rytsh/tren/docs/standart.md

# Tren ortak standardı

Bütün lokomotif ve vagonların uyması gereken ölçü, bağlantı ve hat (bus) standardı. **Durum: tasarım önerisi.** Hiçbir parça basılmadı; çeki kolu, konnektör, akım ve veri hattı fiziksel olarak denenmedi. Varsayımlar `cad/params.json` içinde parametredir ve test sonrası değişebilir.

## 1. Ölçü

| | Değer | Not |
|---|---|---|
| Ray açıklığı | 45 mm | değişmez |
| Standart vagon şasisi | **250 × 90 mm** | eski 220 mm yolcu vagonunun yerine; 256 mm tablaya düz sığar |
| Gövde | ≤ 236 × 86 mm | çatı ayrı baskı |
| Boji merkezleri | ±75 mm (150 mm aralık) | boji aks aralığı 48 mm; uç tekerlek x = 122,5 mm, kiriş yüzü 125 mm |
| Kirişler arası | **40 mm** (iki 250 vagon); araç adımı 290 mm | R750'de iç tampon başları arası ≈ 11 mm (`coupling_calc.py`) |
| Gövde yüksekliği | ≤ 135 mm ray üstü (çatı dahil), donanım (radar vb.) ≤ 160 mm | lokomotif bacası 155 mm |
| Çeki kolu pim aralığı | lokomotif–tender 44 mm, tender–250 86 mm, 250–250 116 mm | `db_pitch`, `dbc_L_tender`, `dbc_L_car` |

R750'de 150 mm boji aralığı: gövde ortası yaklaşık 3,8 mm içe, uçlar yaklaşık 6,7 mm dışa kayar (s²/8R). Çeki kolu bunu pivotunda dönerek karşılar (≈ 11°, çentik ±12°); yan tamponlar yalnız görseldir ve virajda birbirine değmeyecek kadar geride durur.

## 2. Bağlantı: çeki kolu + ara kablo

Mekanik bağlantı ile elektrik ayrıdır. Önceki öneri (T45: koni–huni, mıknatıs, 8 pogo temas tek kafada) bu ölçekte fazla parça, ince duvar ve ±0,5 mm hizalama istediği için bırakıldı.

- **Çeki kolu.** Tek parça, düz basılan bir kol (8 × 5,5 mm). Her 250 vagonun **ön** ucunda, platform altındaki pivot göbeğine (kiriş yüzünden 38 mm içeride) alttan M3 vidayla takılır; öbür ucu öndeki aracın **arka** pivotuna gelir. Vida pulla takılır, sıkılmaz: kol iki pivotta da serbest döner. Kiriş altındaki çentik kola ±12° salınım verir.
- **Lokomotif ve tender.** Eski Faz 3 çeki çatalları kalır: lokomotif–tender arasında 44 mm kol; tender arka çatalı ile ilk 250 vagonun ön pivotu arasında 86 mm kol.
- **Kuvvet.** Çekme ve itmeyi yalnız kol ve pimler taşır. Tamponlar görseldir.
- **Elektrik.** Her araç gövdesinin iki alın duvarında bir **4 pinli kutuplu yuva** vardır (JST-XH 4P sınıfı, ölçü varsayım, ray üstünden ≈ 63 mm). Araçlar arasına 80 mm'lik, iki ucu fişli 4 damarlı **ara kablo** elle takılır. Kablo kuvvet taşımaz; yuvanın arkasında kablo bağıyla tutulur. Tender deposu da aynı 4 pinli yuvayı taşır; lokomotifte yuva yok, tenderden gelen kablo kabin arka açıklığından girer.

Pin sırası (yuvada kutuplama kanalı üstte, soldan sağa):

| Pin | Hat | Açıklama |
|---|---|---|
| 1 | **BAT+** | tren besleme hattı, 2S pil gerilimi 6,0–8,4 V, sigortalı |
| 2 | **CAN-H** | veri hattı |
| 3 | **CAN-L** | veri hattı |
| 4 | **GND** | ortak toprak |

## 3. TrenBus: güç + veri

- **Güç.** BAT+ hattı lokomotif ve **enerji vagonlarındaki** paketlerden beslenir. Her besleyici hatta ideal diyot ve akım sınırı (öneri 2 A) ile bağlanır; her tüketici araç girişinde PTC/eFuse (öneri 1 A) ve kendi düşürücü regülatörü (5 V / 3,3 V) vardır. Hiçbir modül BAT+ hattını doğrudan 5 V sanmaz.
- **Veri.** CAN 2.0, öneri 125 kbit/s. Her araçta küçük bir **araç düğümü**: mikrodenetleyici (ör. ESP32-C3) + 3,3 V CAN alıcı-verici (ör. SN65HVD230). Sonlandırma: lokomotifte sabit 120 Ω, son araçta arka yuva boşsa düğümün açtığı 120 Ω (öneri, doğrulanmadı).
- **Mesajlar (öneri).** Lokomotif periyodik `durum` (hız, yön, pil) yayınlar; araçlar `kalp atışı` ve kendi telemetrisini gönderir; lokomotif `komut` ile ışık, ses, radar gibi işlevleri açar. Araç sırası kalp atışlarından çıkarılır.
- **Şarj ayrı.** İstasyon şarj kontakları TrenBus'tan ayrı bir devredir; şarj akımı ara kablodan geçirilmez, şarj vagonu yalnız kendi paketini ve kendi döner kollarını kullanır (§5).

## 4. Araç ailesi (ilk set)

| id | Ad | Görev | Hat |
|---|---|---|---|
| `bd-040` | BD 0-4-0 lokomotif | çekiş, ana pil, CAN yöneticisi | BAT+ besler, CAN |
| `tender-160` | Tender 160 | kömürlük görünümünde ana pil | BAT+ besler |
| `yolcu-250` | Yolcu 250 | iç aydınlatma, pencere ışıkları | tüketir, CAN |
| `enerji-250` | Enerji vagonu | ek 2S paket + BMS, gerilim göstergesi | BAT+ besler, CAN |
| `radar-250` | Radar vagonu | dönen anten tablası, mesafe sensörü | tüketir, CAN |
| `sarj-250` | Şarj vagonu | döner şarj kolları, şarj durumu ışık çubuğu | kendi devresi, CAN |
| `ses-250` | Ses vagonu | hoparlör, düdük ve anons | tüketir, CAN |
| `gozlem-250` | Gözlem vagonu | kamera kubbesi, gözlem pencereleri | tüketir, CAN |

Hepsi ortak 250 mm şasi, iki boji, bir çeki kolu ve iki TrenBus yuvası kullanır; yalnız gövde ve üst donanım değişir. Gövde CAD parçaları (`cad/README.md` Faz 4c):

| id | Gövde parçaları | Üst yükseklik (ray üstü) |
|---|---|---|
| `yolcu-250` | `yolcu_govde`, `yolcu_cati` | ≈ 131 mm |
| `enerji-250` | `enerji_govde`, `enerji_cati` | ≈ 128 mm |
| `radar-250` | `radar_kabin`, `radar_cati`, `radar_kaide`, `radar_tabla`, `radar_direk`, `radar_anten` | çanak ≈ 147 mm |
| `sarj-250` | `sarj_platform`, `sarj_govde`, `sarj_cati`, `sarj_kol` | ≈ 100 mm |
| `ses-250` | `ses_govde`, `ses_cati` | ≈ 129 mm |
| `gozlem-250` | `gozlem_govde`, `gozlem_cati`, `gozlem_kubbe` | kubbe ≈ 134 mm |

## 5. İstasyon şarjı: döner kollar

**Durum: tasarım önerisi, CAD'i üretildi** (`cad/README.md` Faz 4, `sarj250_montaj`). Servo, yaprak yay ve lama ölçüleri varsayımdır; temas direnci ve akım denenmedi.

| | Değer | Parametre |
|---|---|---|
| Kol cebi | +y yan duvarında, 35 × 10 × 27 mm (boy × derinlik × yükseklik) | `sj_pk_*` |
| Mil ekseni | x = 12, y = 35 (araç merkezinden) | `sj_px`, `sj_py` |
| Kol boyu | milden tutucu ucuna 22 mm, yaprak yay +4 mm | `sj_arm_len`, `sj_shoe_out` |
| Yay stroku | 1,5 mm (istasyon lamasının bastırdığı) | `sj_travel` |
| Kutup | üst kol **+**, alt kol **−**; eksenler arası 18 mm | `sj_up_z`, `sj_lo_z` |
| İstasyon lama yüzü | ray ekseninden 59,5 mm | `sj_st_face` |
| Lama eksenleri | zeminden 72 mm (−) ve 90 mm (+) (ray üstünden ≈ 59 ve 77) | `sj_st_z_lo`, `sj_st_z_up` |
| Lama boyu | 90 mm temas yüzü (6 × 1 mm pirinç, 100 mm kesilir) | `sj_st_len` |

- **Vagon tarafı.** Tek parça döner kol: dikey göbek ve ona bağlı alt ve üst kol. Platform altındaki tek mikro servo (MG90S sınıfı) göbeği çeyrek tur döndürür, iki kol birlikte kapı gibi açılır. Kapalıyken kollar cebin içinde −x yönüne yatar ve gövde dış yüzünün içinde kalır.
- **Kol ucu.** Tutucudaki yuvaya fosfor bronz/pirinç yaprak yay şerit (5 × 0,3 mm) yapıştırılır ve dışarı kıvrılır. Lamaya servo kuvvetiyle değil yayla bastırır; servo açık konumda durur.
- **İstasyon tarafı.** `sarj_istasyon` tutucusu traverslerle aynı zemine oturur: iki direk ve üst üste iki taşıyıcı. Lamalar taşıyıcıların ray tarafındaki cebe girer, yüzleri plastiğin 0,5 mm önündedir; uçları direk yarığına bükülür. Lamalar 90 mm olduğu için vagonun ±40 mm kayık durması temasa engel olmaz.
- **Akış.** Mıknatıslar ve hall sensörüyle durulur, kollar açılır ve temas doğrulanana kadar lamalar enerjisiz kalır. Şarj biter, kollar cebe döner. Vagon ancak kollar kapandıktan sonra kalkar (servo konumu veya cepte bir uç anahtarı, öneri).
- **Koruma.** Vagon girişinde ters kutup koruması ve sigorta bulunur, BMS 2S paketi korur.

## 6. Görsel dil

Site ve Anatomy figürleri aynı sıcak, sarıya çalan paleti kullanır: kum sarısı zemin, krem çizim kâğıdı, sıcak koyu mürekkep, kırmızı tekerlek, işaret sarısı vurgu. Logo: [Lucide `train-track`](https://lucide.dev/icons/train-track).

| Token | Renk |
|---|---|
| ground | `#efe6c8` |
| plate (kâğıt) | `#faf5e4` |
| ink | `#2b2616` |
| mid | `#6e6448` |
| hair | `#d6caa3` |
| signal (vurgu sarısı) | `#e9b824` |
| red (tekerlek) | `#b3262a` |
