rytsh/tren/cad/renders/ceki_kolu.png

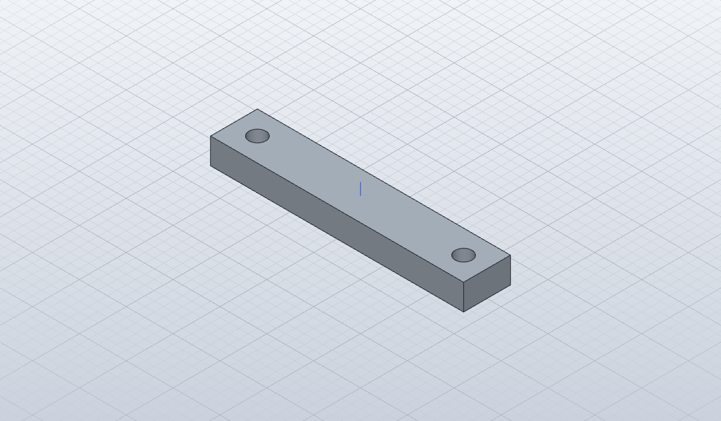
cad/renders/ceki_kolu.png
