rytsh/tren/cad/renders/ceki_kolu_250.png

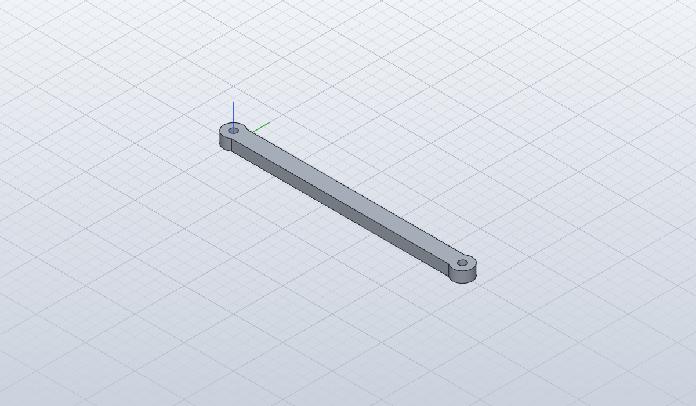
cad/renders/ceki_kolu_250.png
