rytsh/tren/cad/renders/ceki_kolu_tender_250.png

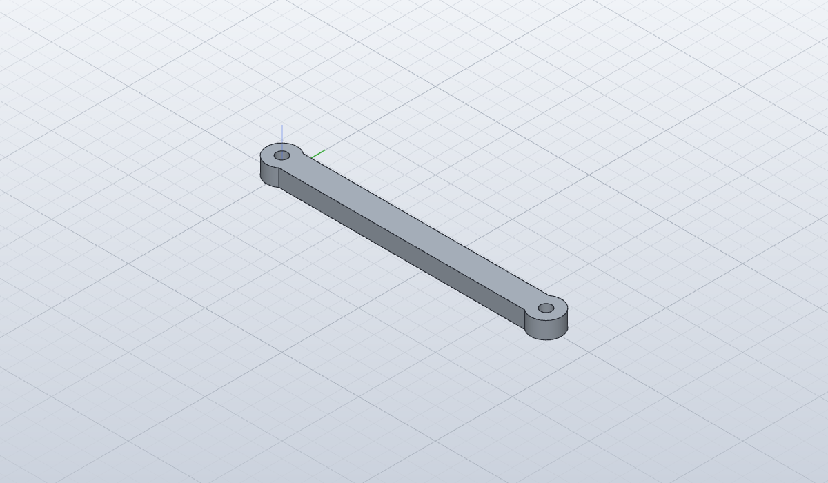
cad/renders/ceki_kolu_tender_250.png
