rytsh/tren/cad/renders/enerji_cati.png

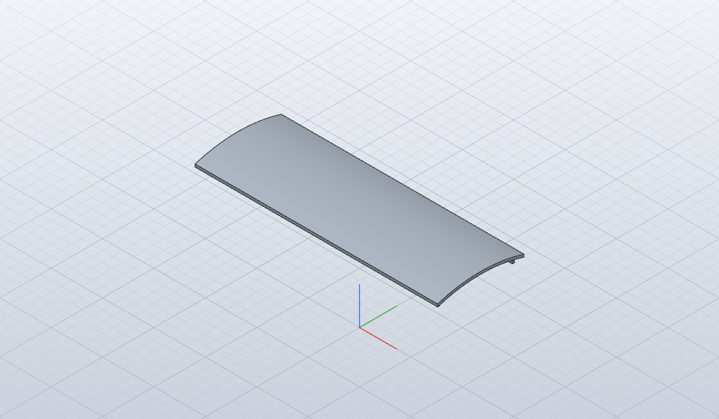
cad/renders/enerji_cati.png
