rytsh/tren/cad/renders/enerji_govde.png

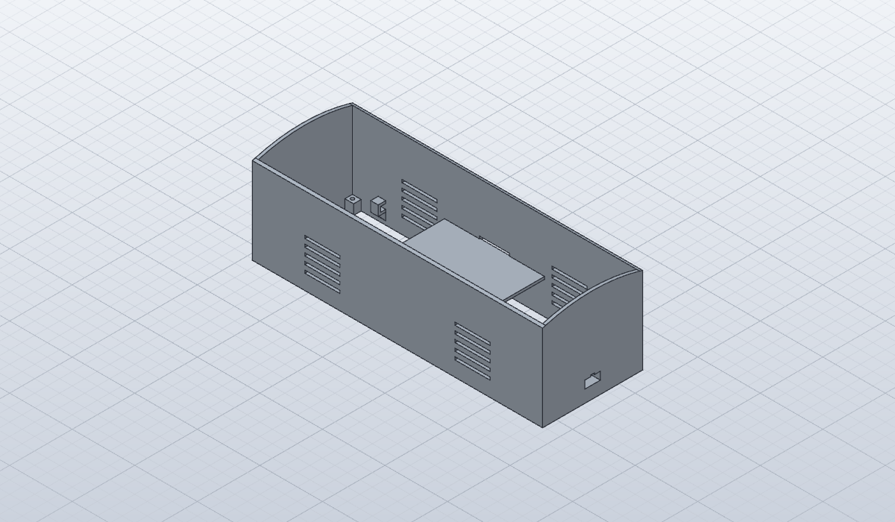
cad/renders/enerji_govde.png
