rytsh/tren/cad/renders/gozlem_cati.png

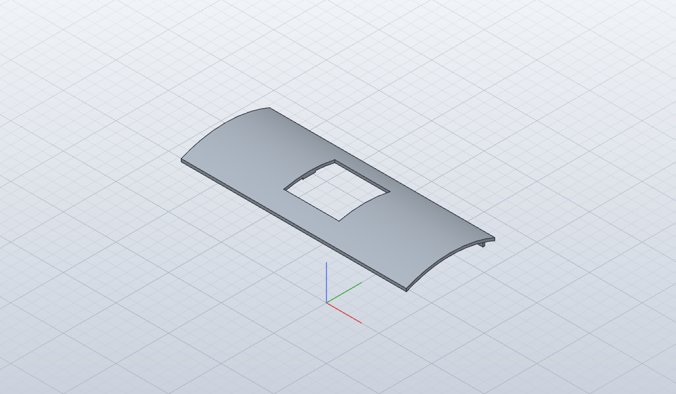
cad/renders/gozlem_cati.png
