rytsh/tren/cad/renders/gozlem_govde.png

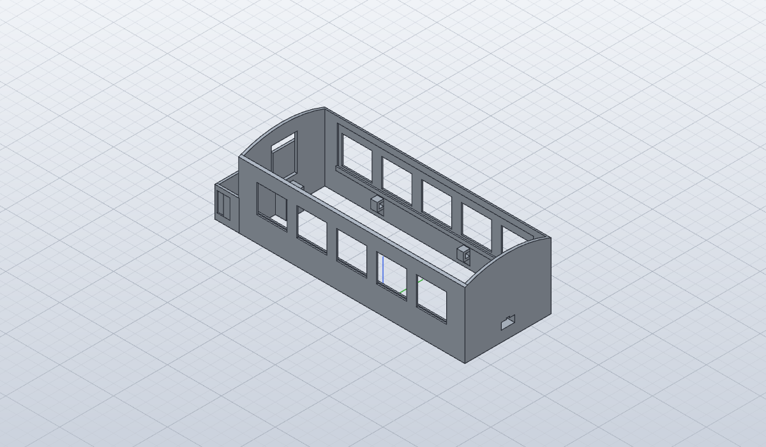
cad/renders/gozlem_govde.png
