rytsh/tren/cad/renders/gozlem_kubbe.png

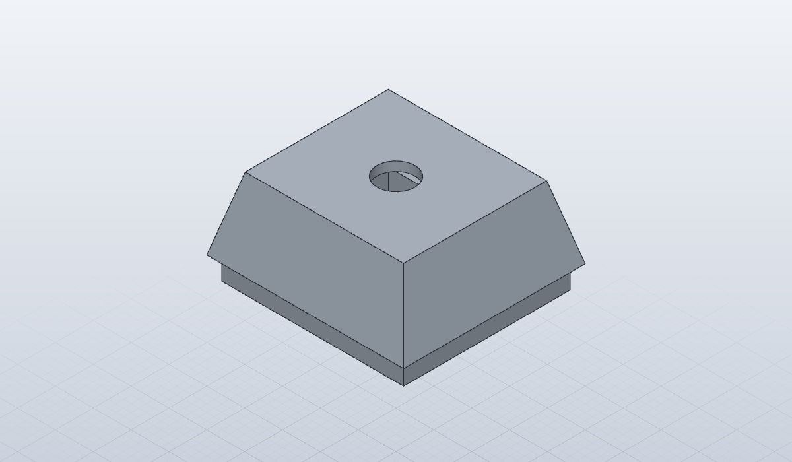
cad/renders/gozlem_kubbe.png
