rytsh/tren/cad/renders/karsi_disli_m1_z30.png

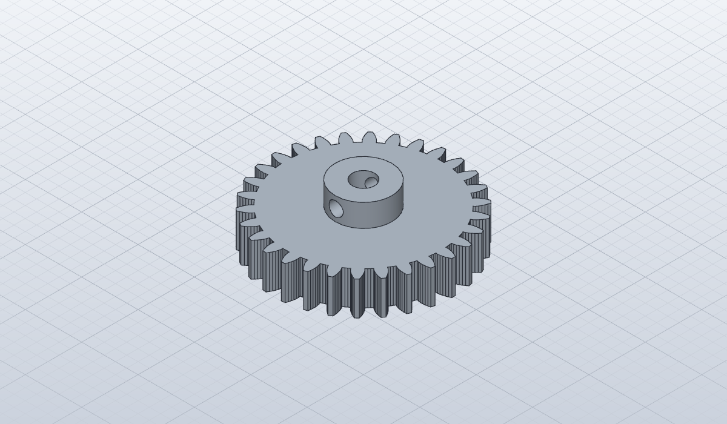
cad/renders/karsi_disli_m1_z30.png
