rytsh/tren/cad/renders/lok_baca.png

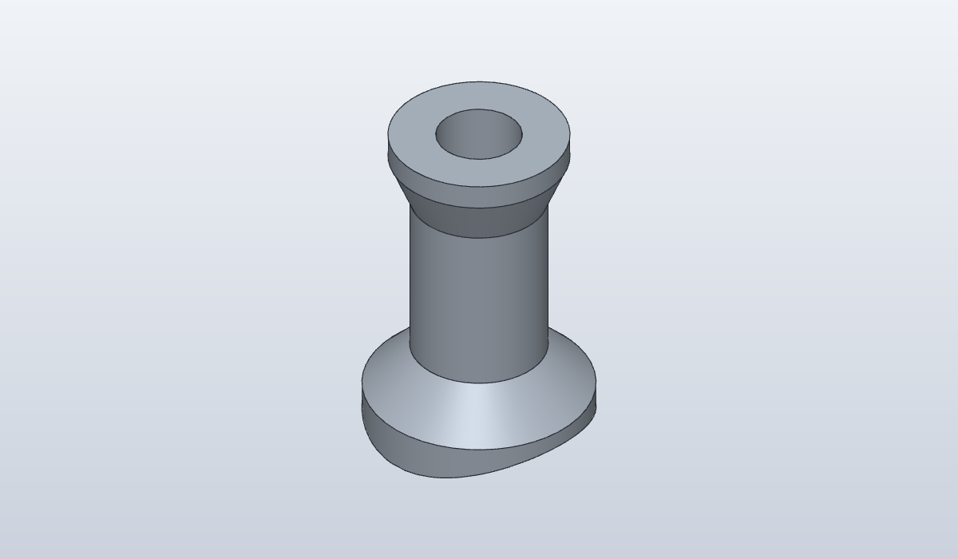
cad/renders/lok_baca.png
