rytsh/tren/cad/renders/lok_buhar_domu.png

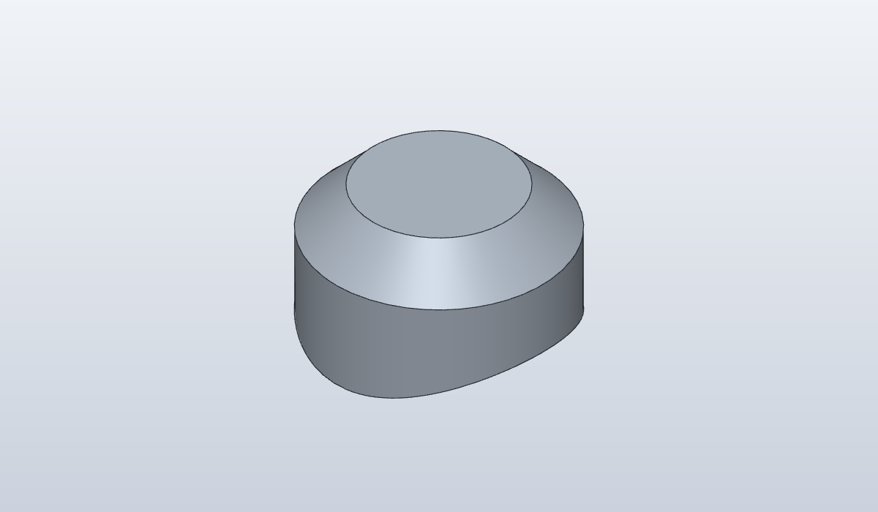
cad/renders/lok_buhar_domu.png
