rytsh/tren/cad/renders/lok_emniyet_ventili.png

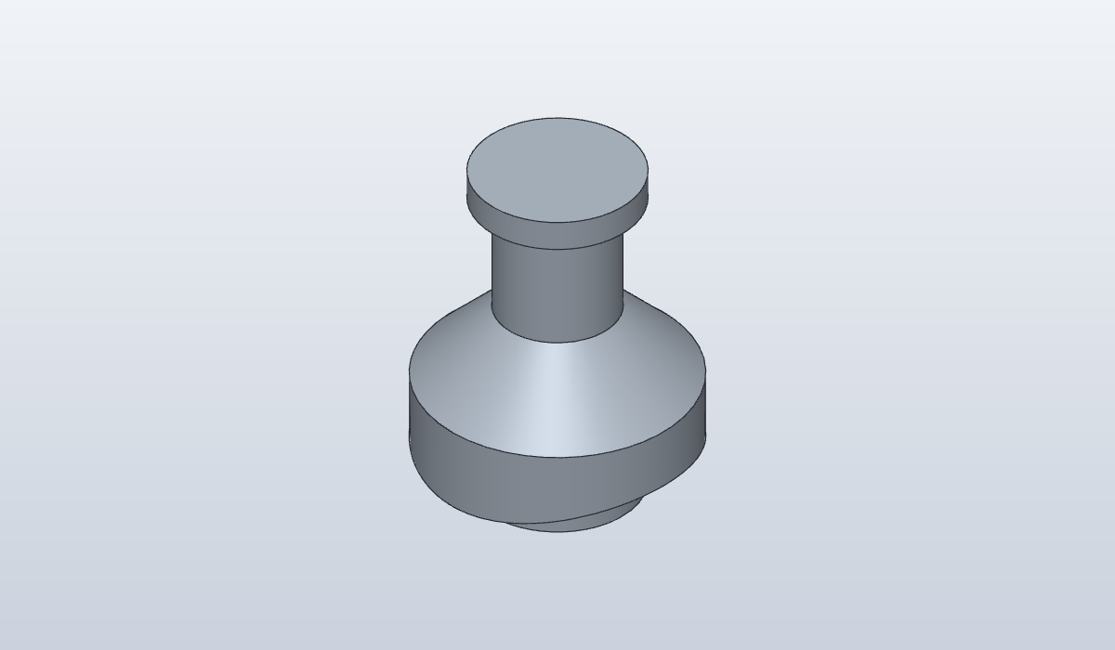
cad/renders/lok_emniyet_ventili.png
