rytsh/tren/cad/renders/lok_kabin.png

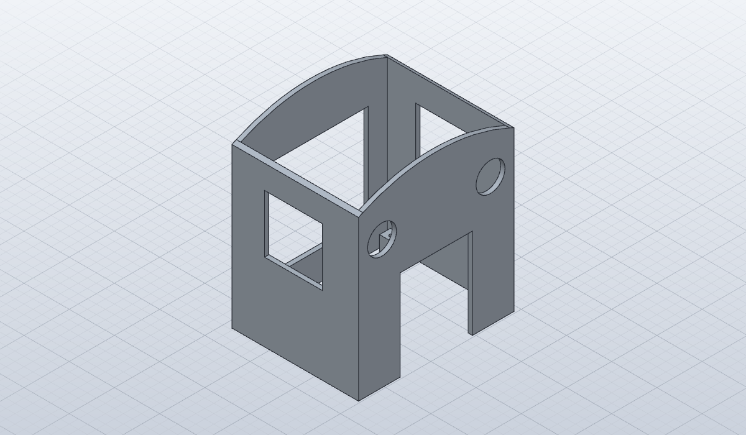
cad/renders/lok_kabin.png
