rytsh/tren/cad/renders/lok_kabin_cati.png

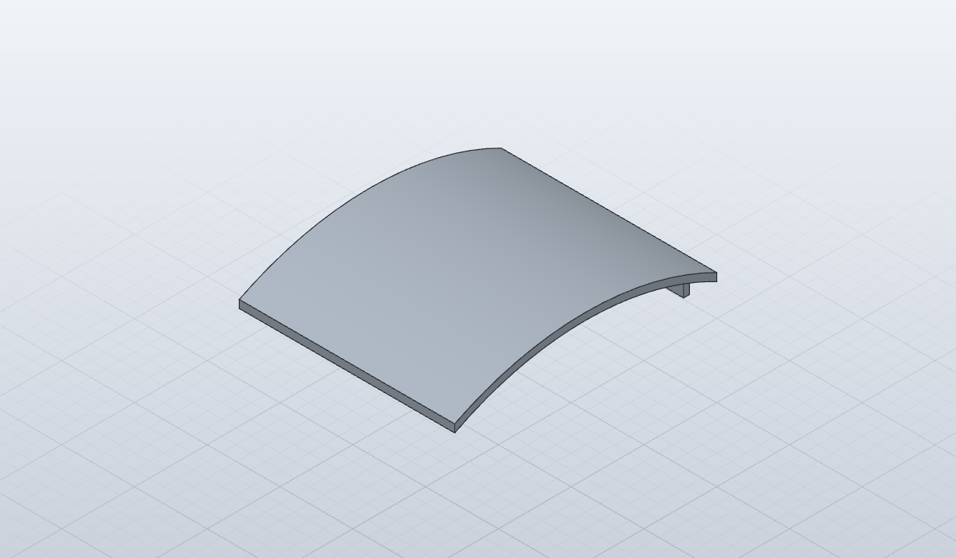
cad/renders/lok_kabin_cati.png
