rytsh/tren/cad/renders/lok_kazan.png

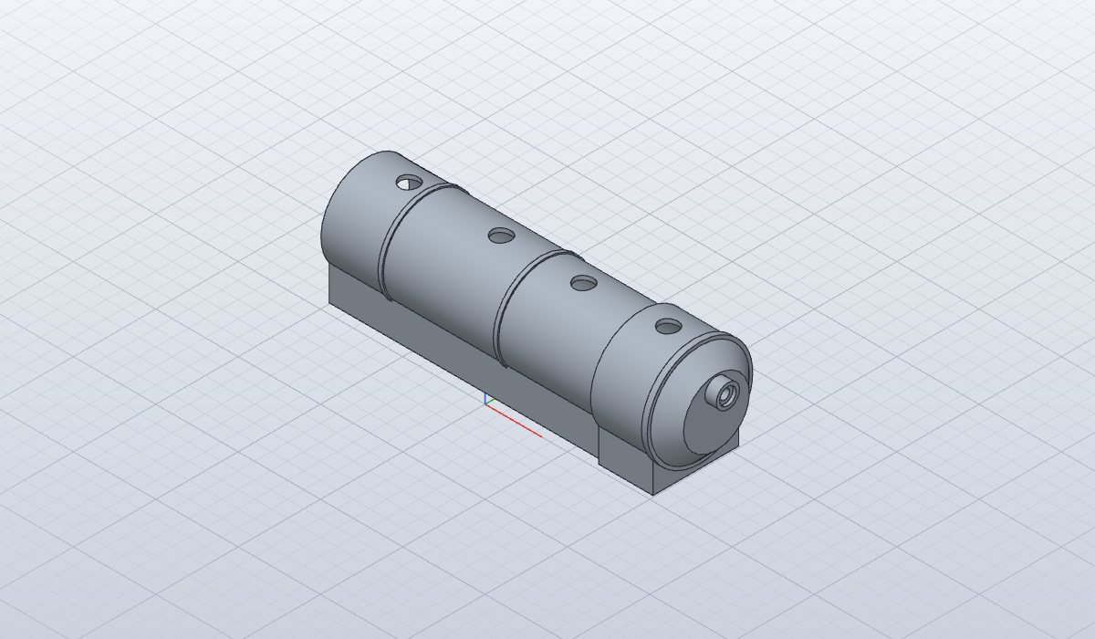
cad/renders/lok_kazan.png
