rytsh/tren/cad/renders/lok_platform_arka.png

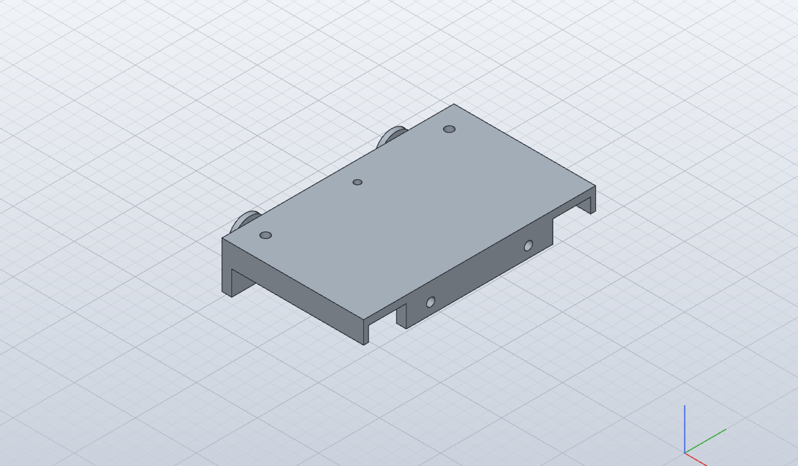
cad/renders/lok_platform_arka.png
