rytsh/tren/cad/renders/lokomotif_yan.png

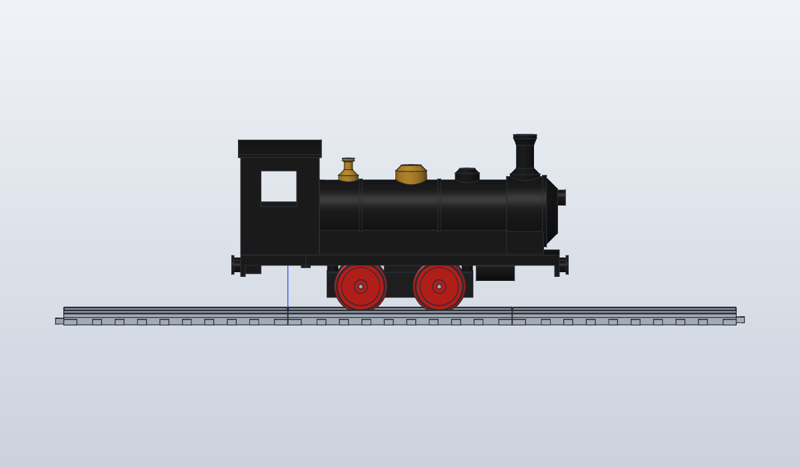
cad/renders/lokomotif_yan.png
