rytsh/tren/cad/renders/motorlu_iso.png

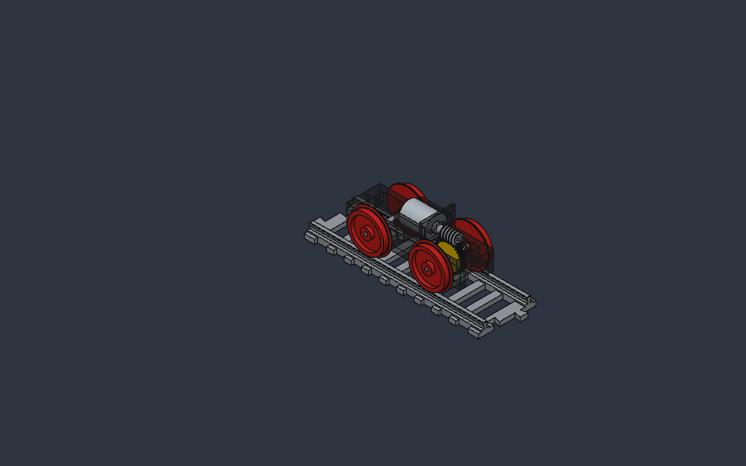
cad/renders/motorlu_iso.png
