rytsh/tren/cad/renders/motorlu_on.png

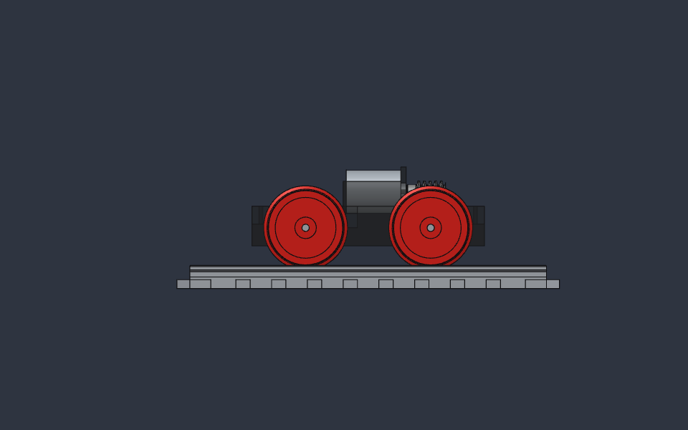
cad/renders/motorlu_on.png
