rytsh/tren/cad/renders/pul_aks_4mm.png

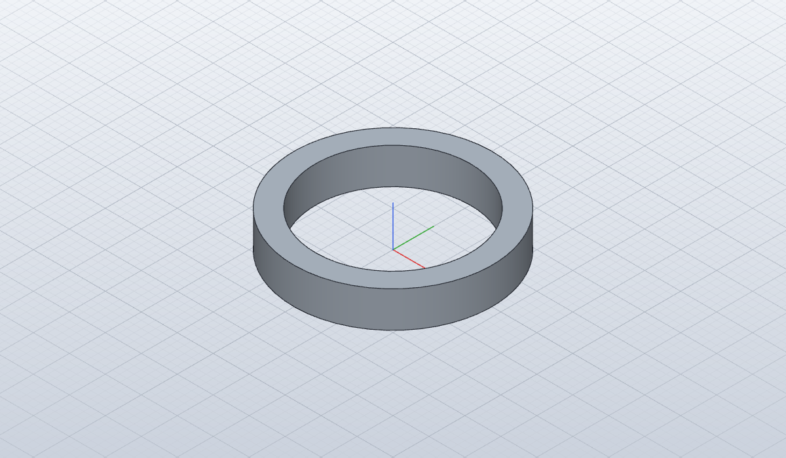
cad/renders/pul_aks_4mm.png
