rytsh/tren/cad/renders/radar_anten.png

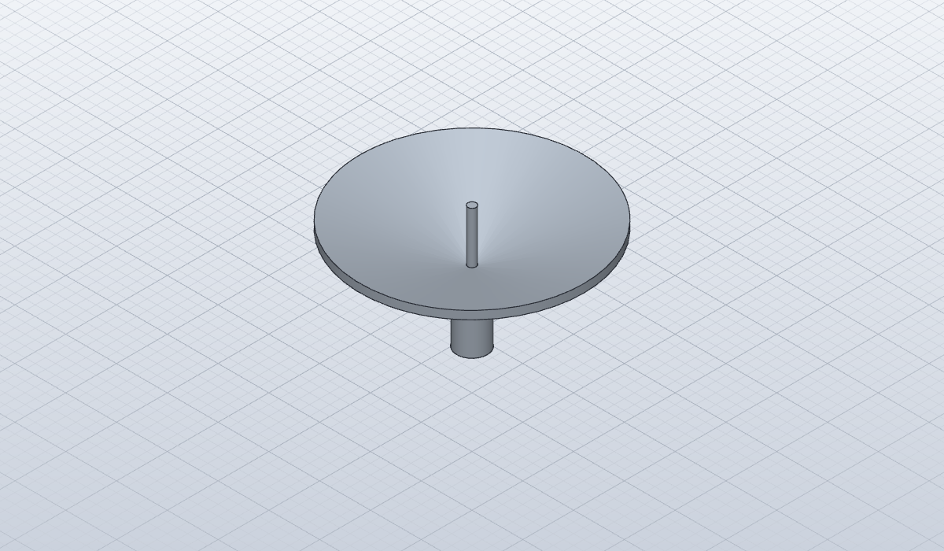
cad/renders/radar_anten.png
