rytsh/tren/cad/renders/radar_cati.png

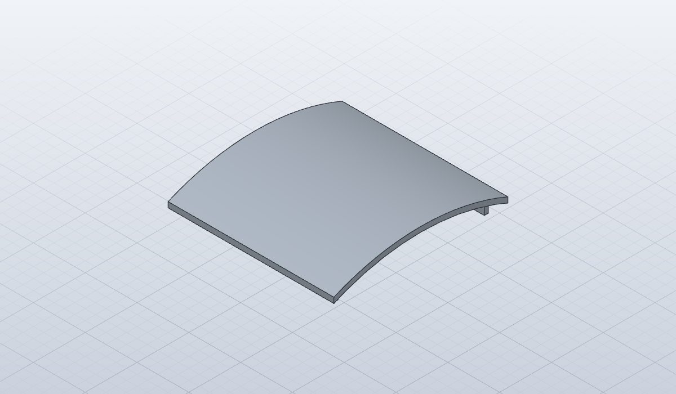
cad/renders/radar_cati.png
