rytsh/tren/cad/renders/radar_direk.png

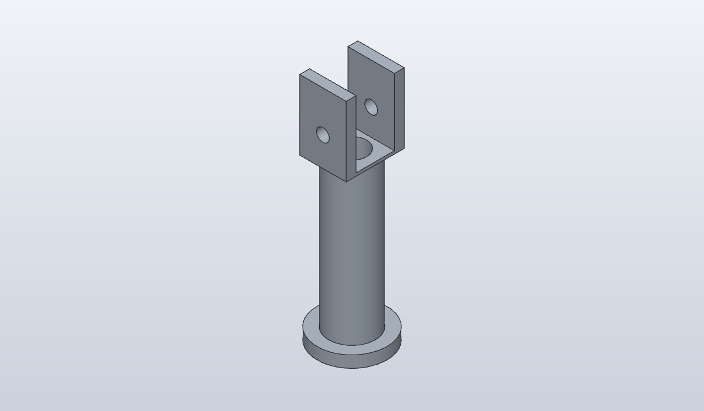
cad/renders/radar_direk.png
