rytsh/tren/cad/renders/radar_kabin.png

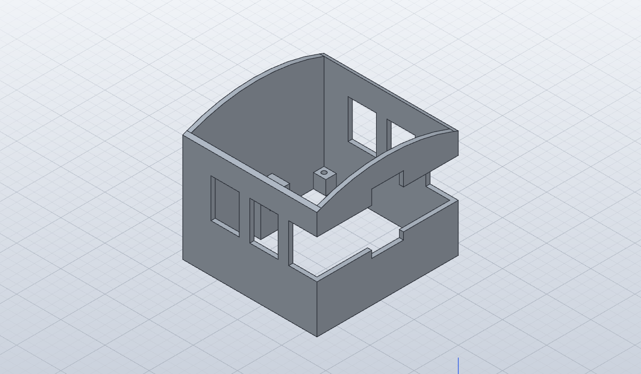
cad/renders/radar_kabin.png
