rytsh/tren/cad/renders/radar_kaide.png

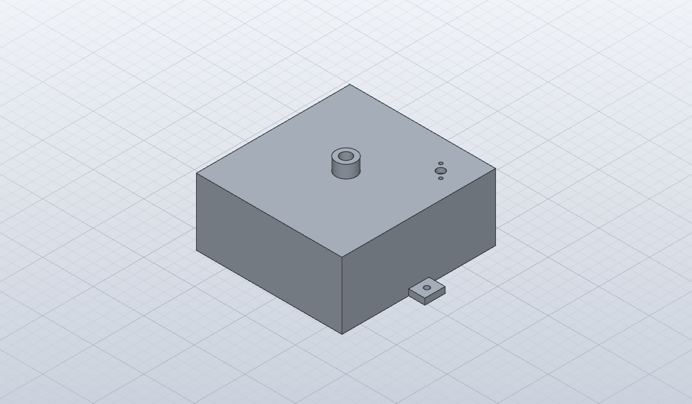
cad/renders/radar_kaide.png
