rytsh/tren/cad/renders/radar_tabla.png

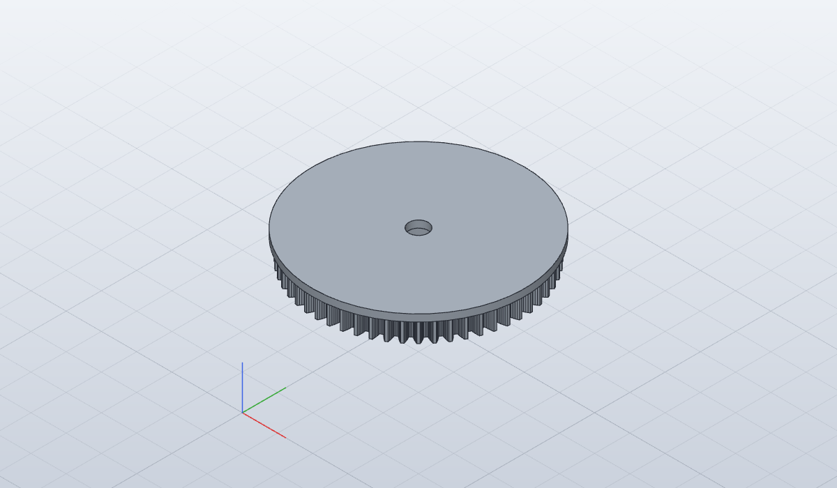
cad/renders/radar_tabla.png
