rytsh/tren/cad/renders/ray_duz_200.png

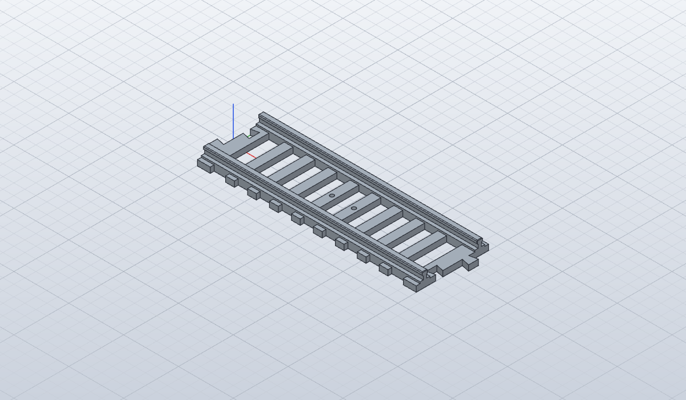
cad/renders/ray_duz_200.png
