rytsh/tren/cad/renders/ray_viraj_r750_15.png

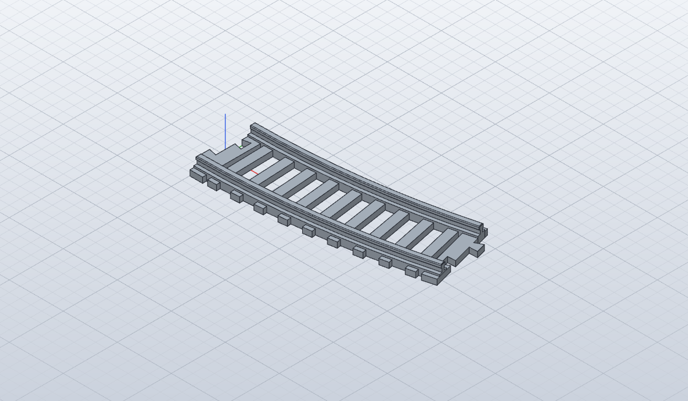
cad/renders/ray_viraj_r750_15.png
