rytsh/tren/cad/renders/sarj_cati.png

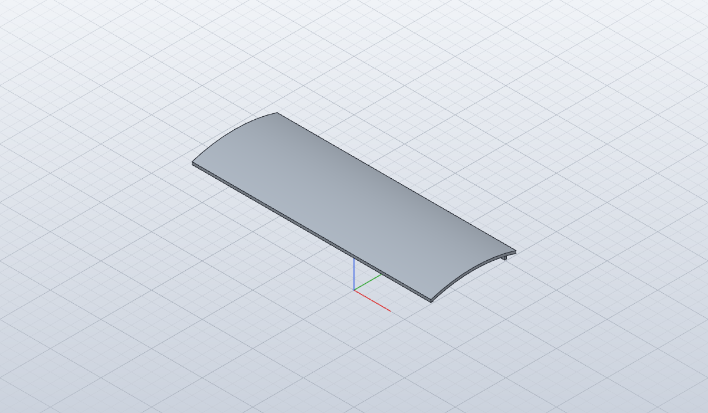
cad/renders/sarj_cati.png
