rytsh/tren/cad/renders/sarj_govde.png

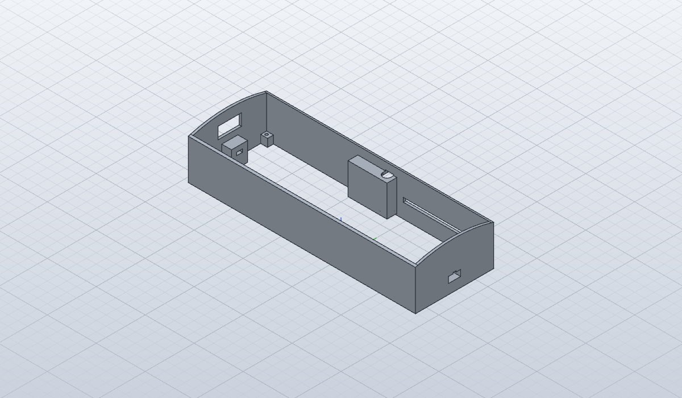
cad/renders/sarj_govde.png
