rytsh/tren/cad/renders/sarj_istasyon.png

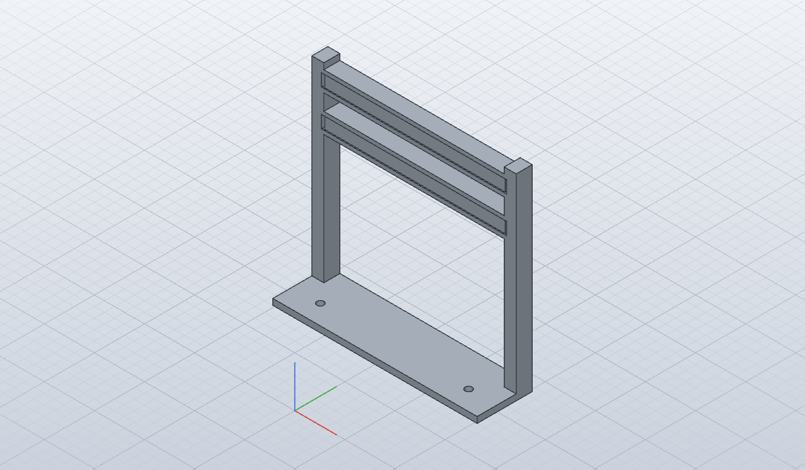
cad/renders/sarj_istasyon.png
