rytsh/tren/cad/renders/sarj_kol.png

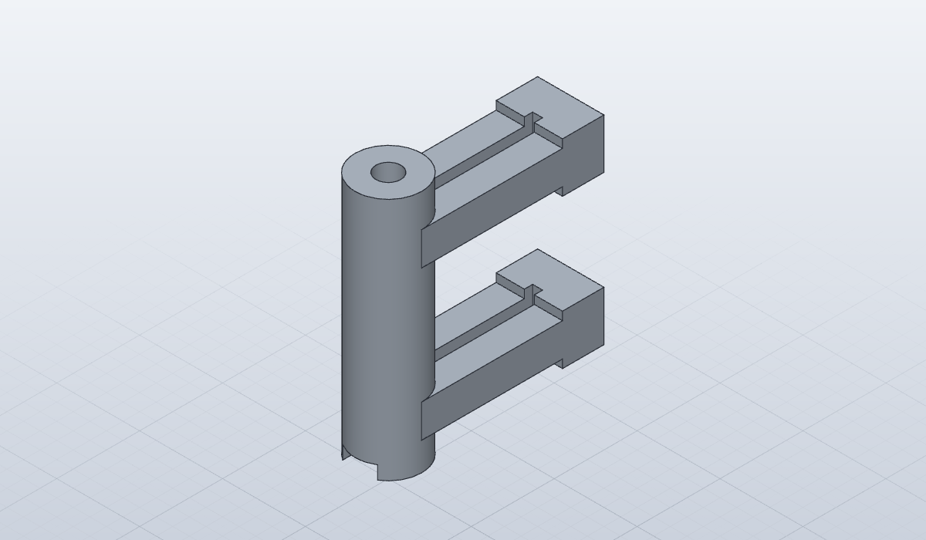
cad/renders/sarj_kol.png
