rytsh/tren/cad/renders/sasi_motorlu_040.png

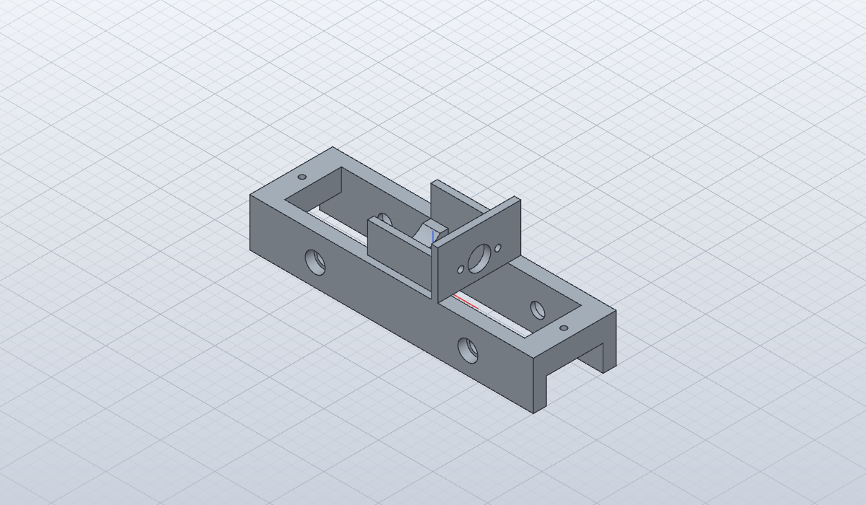
cad/renders/sasi_motorlu_040.png
