rytsh/tren/cad/renders/sonsuz_vida_m1.png

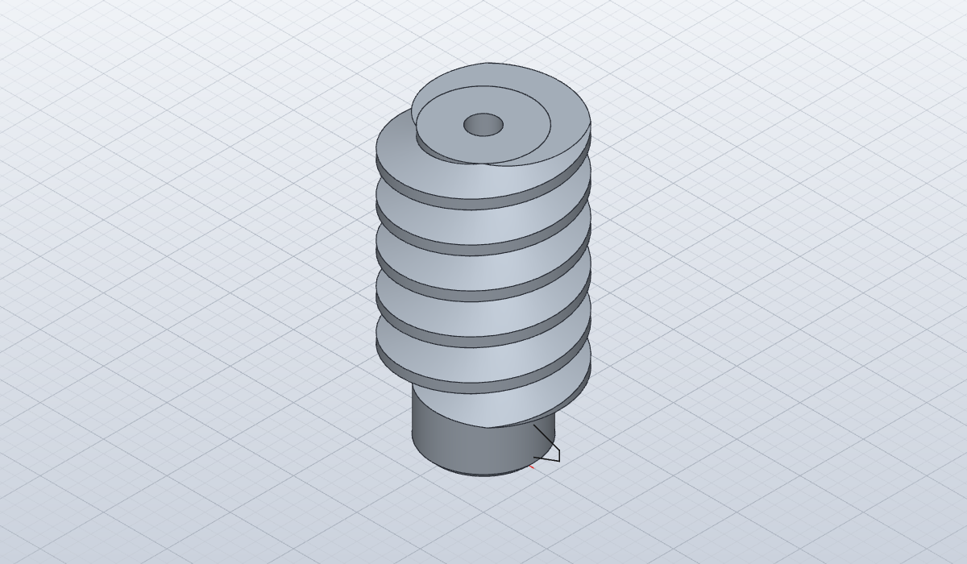
cad/renders/sonsuz_vida_m1.png
