rytsh/tren/cad/renders/tampon_250.png

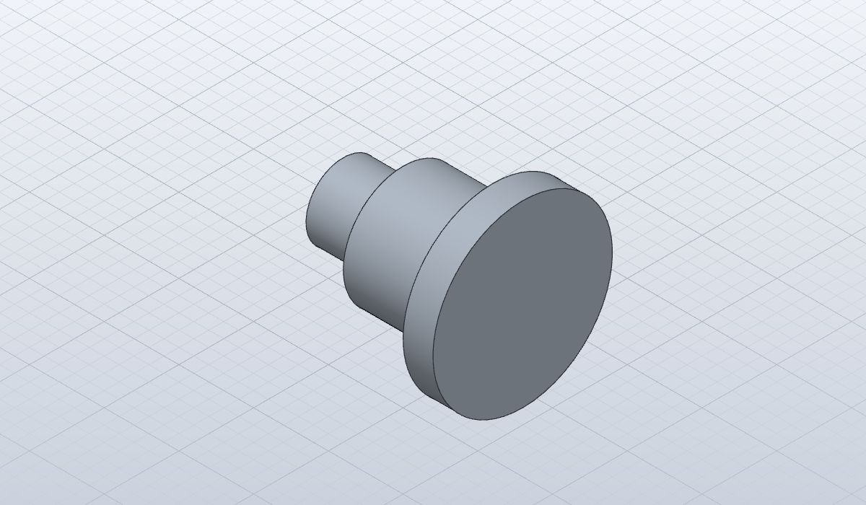
cad/renders/tampon_250.png
