rytsh/tren/cad/renders/tender_depo.png

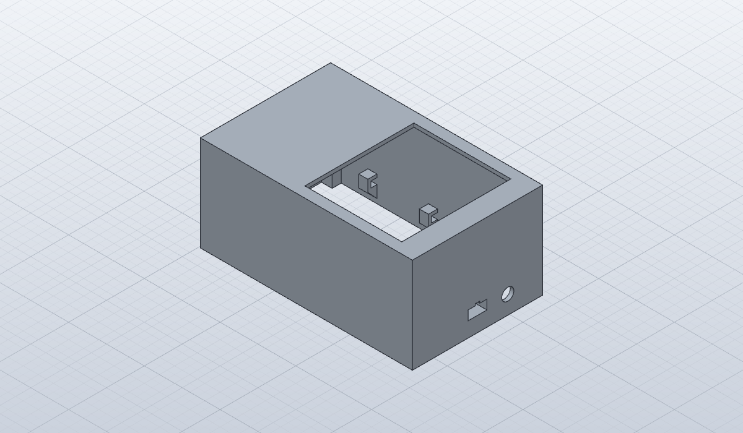
cad/renders/tender_depo.png
