rytsh/tren/cad/renders/tender_iso.png

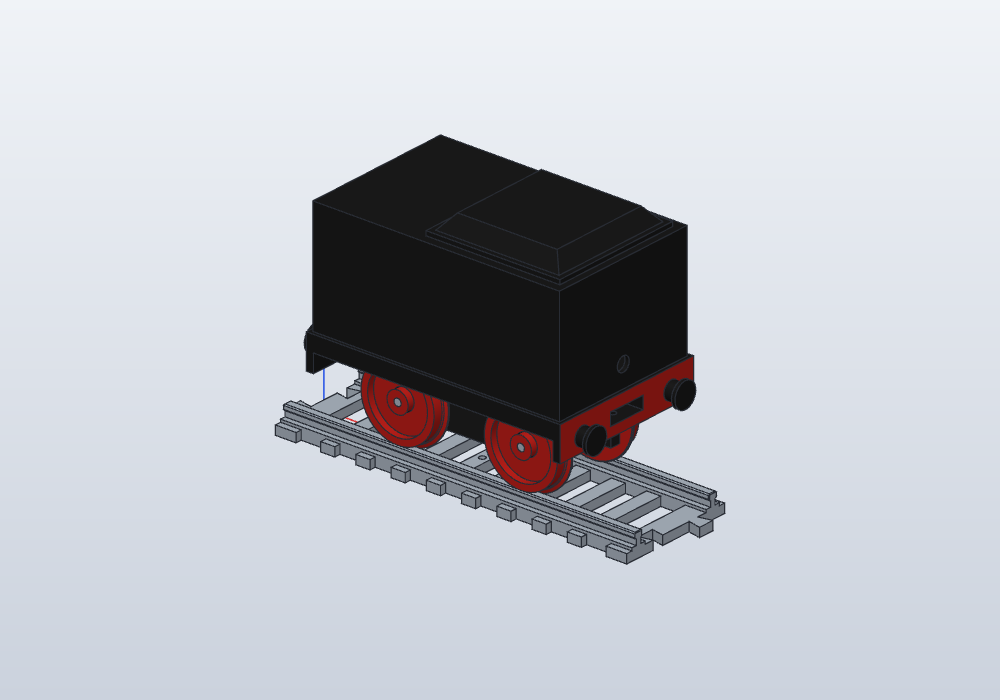
cad/renders/tender_iso.png
