rytsh/tren/cad/renders/tender_kapak.png

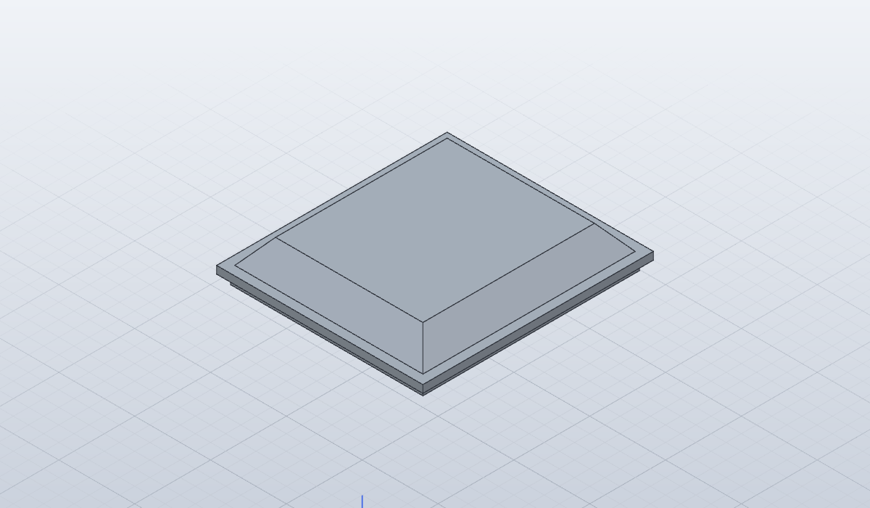
cad/renders/tender_kapak.png
