rytsh/tren/cad/renders/tender_platform.png

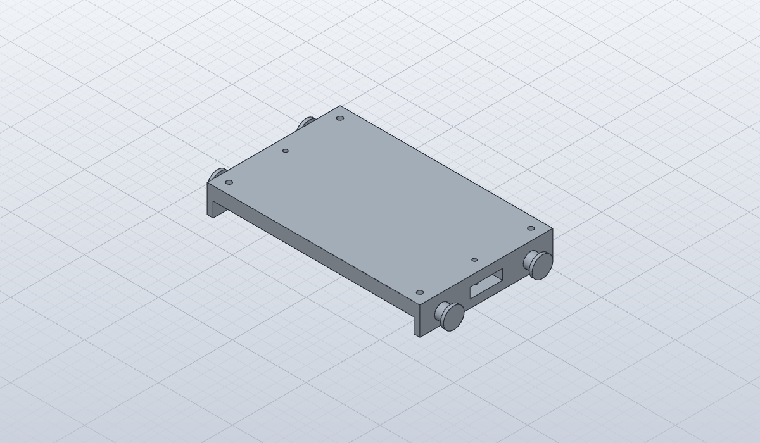
cad/renders/tender_platform.png
