rytsh/tren/cad/renders/tender_sasi.png

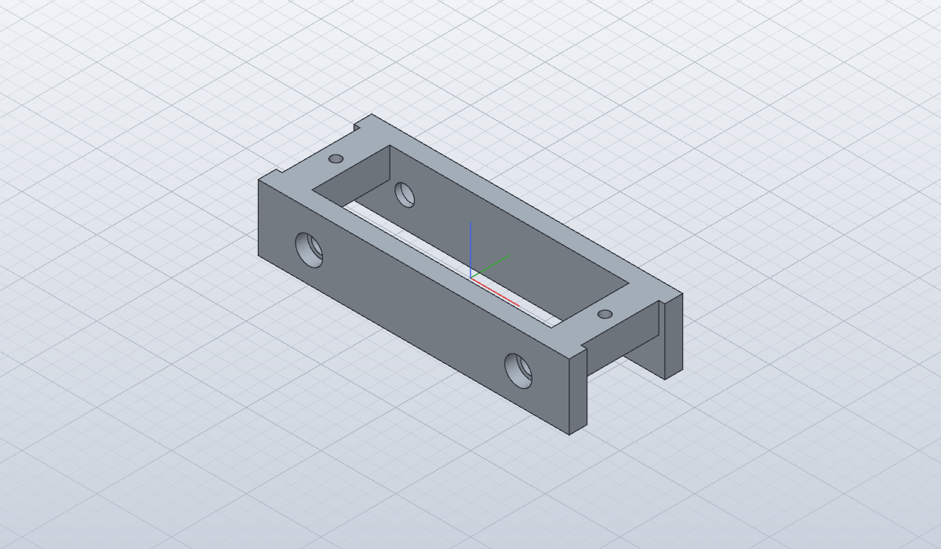
cad/renders/tender_sasi.png
