rytsh/tren/cad/renders/tolerans_kuponu.png

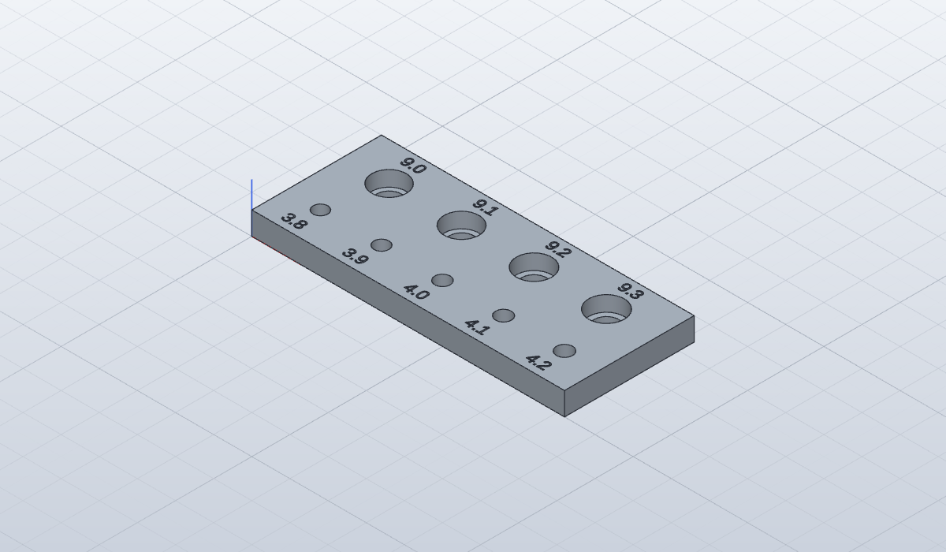
cad/renders/tolerans_kuponu.png
