rytsh/tren/cad/renders/vagon_boji.png

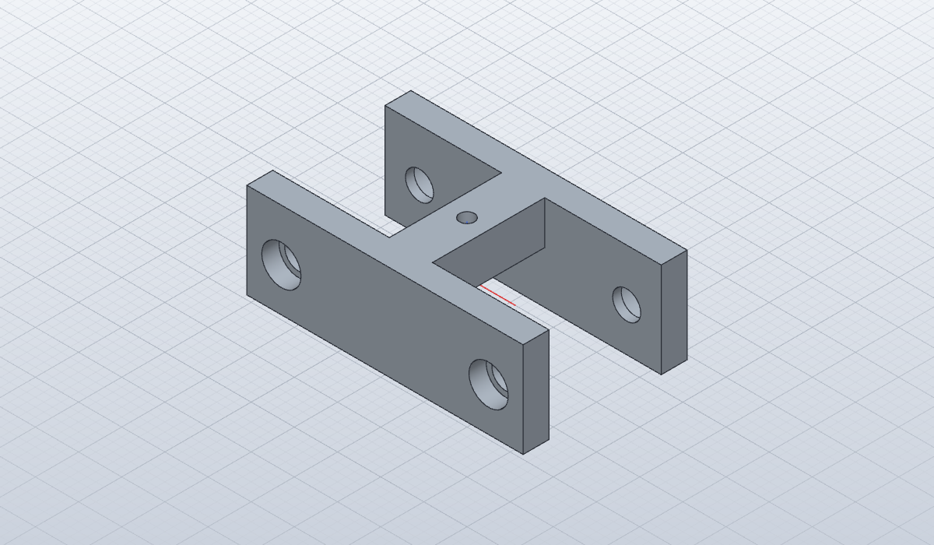
cad/renders/vagon_boji.png
