rytsh/tren/cad/renders/vagon_cati.png

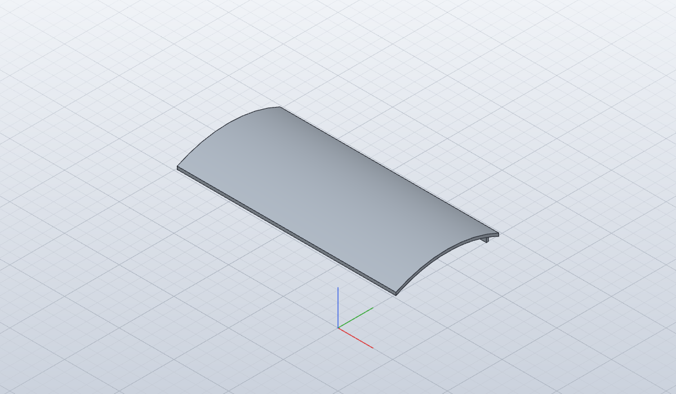
cad/renders/vagon_cati.png
