rytsh/tren/cad/renders/vagon_govde.png

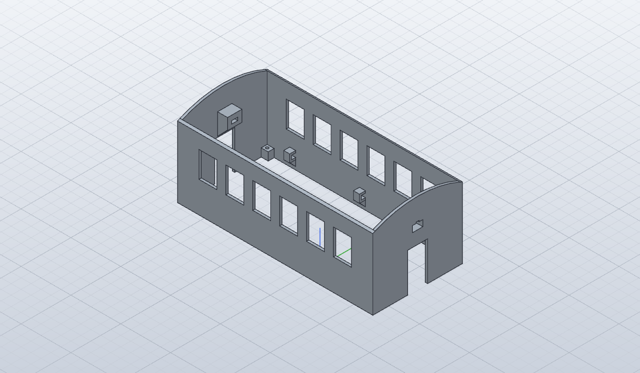
cad/renders/vagon_govde.png
