rytsh/tren/cad/renders/vagon_kablo_ucu.png

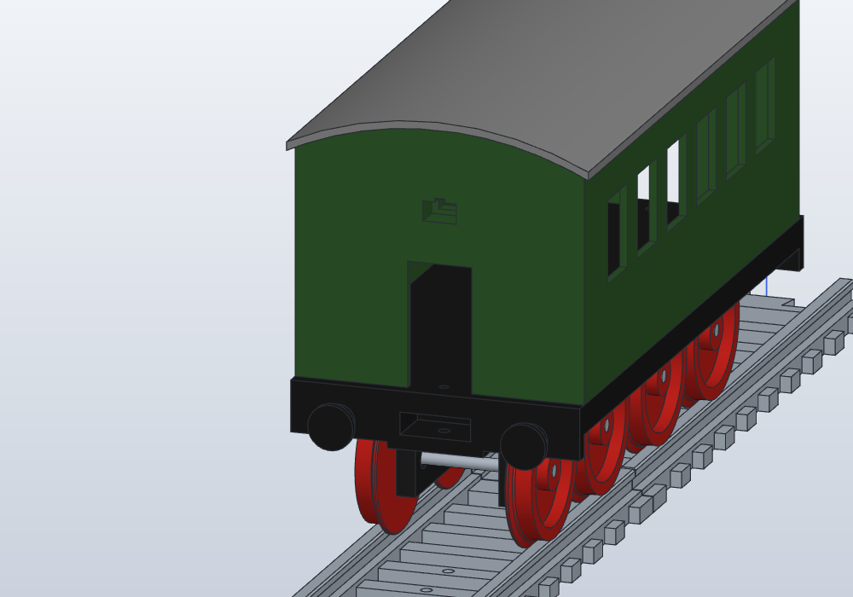
cad/renders/vagon_kablo_ucu.png
