rytsh/tren/cad/renders/vagon_platform.png

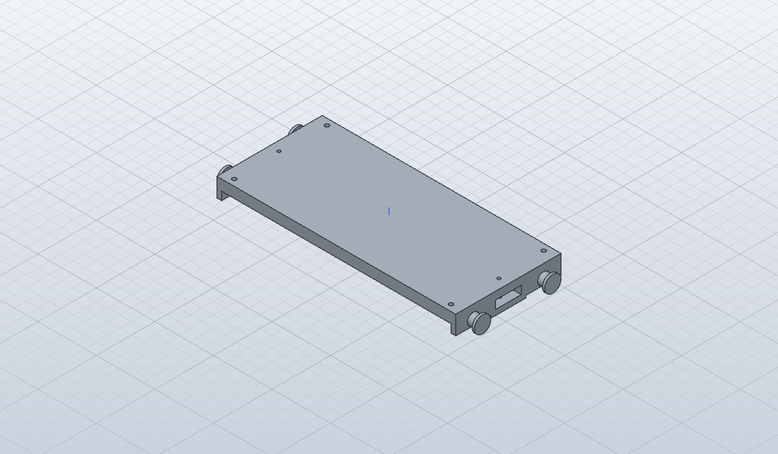
cad/renders/vagon_platform.png
