rytsh/tren/cad/renders/viraj_cift.png

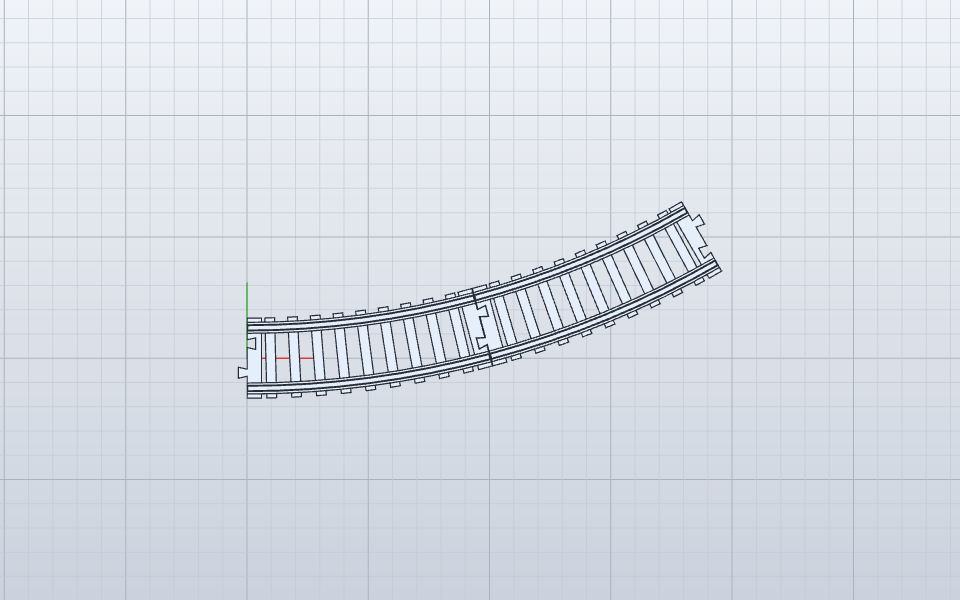
cad/renders/viraj_cift.png
