rytsh/tren/site/assets/20160910-feldbahn-wiesloch-msgb-dampflok-29468815534.jpg

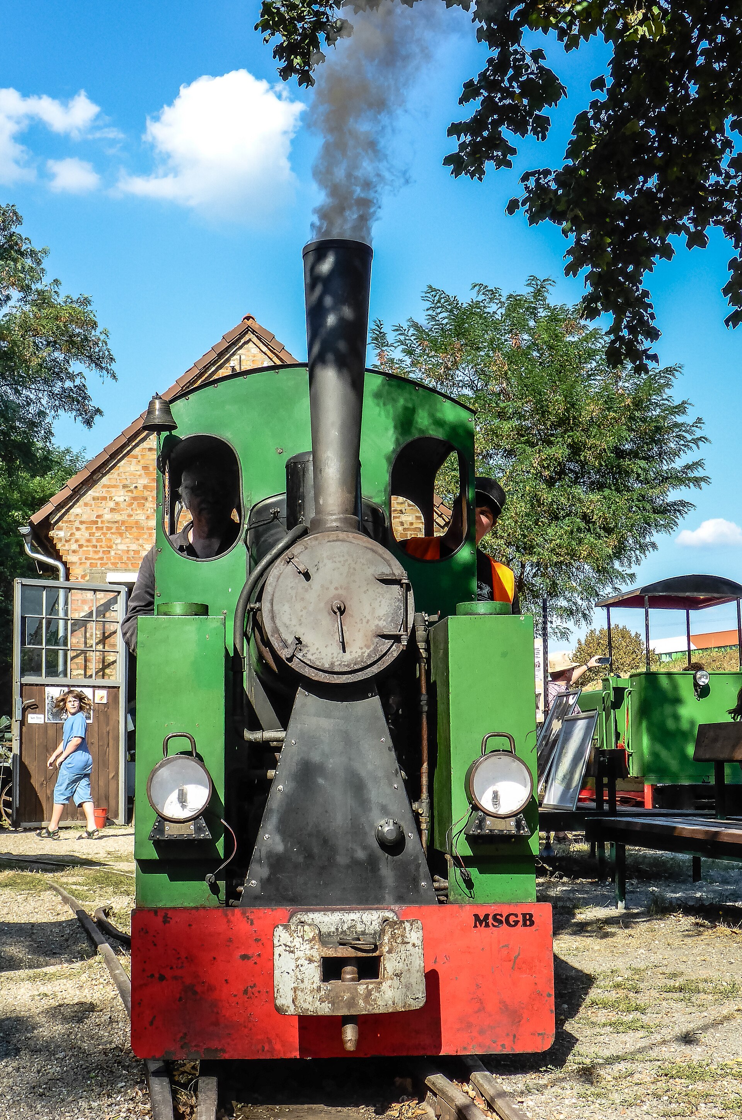
site/assets/20160910-feldbahn-wiesloch-msgb-dampflok-29468815534.jpg
