rytsh/tren/site/assets/henschel-feldbahn-dampflok-wien-33.webp

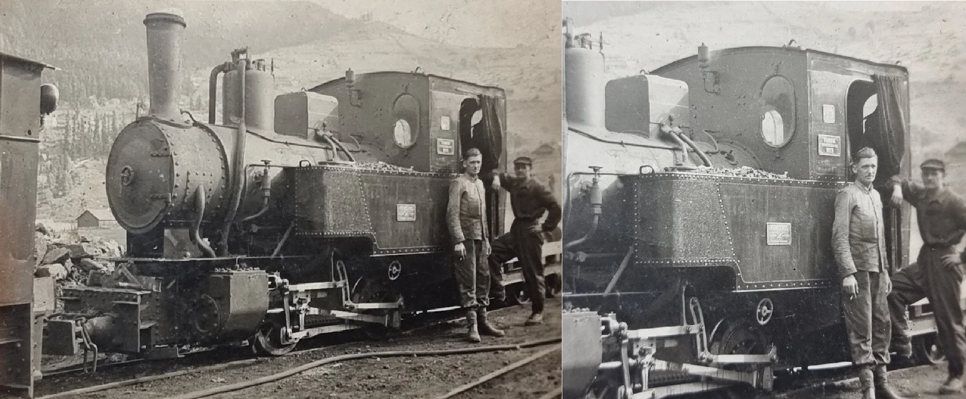
site/assets/henschel-feldbahn-dampflok-wien-33.webp
