rytsh/tren/site/assets/locomotive-pour-voie-d-un-metre-construite.jpg

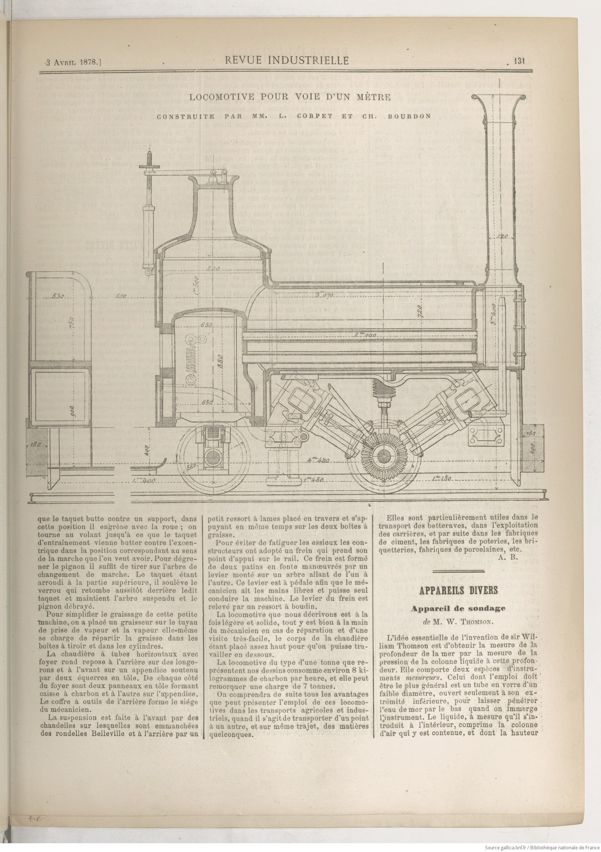
site/assets/locomotive-pour-voie-d-un-metre-construite.jpg
