rytsh/tren/site/assets/narrow-gauge-steam-locomotive-with-short-rounded.jpg

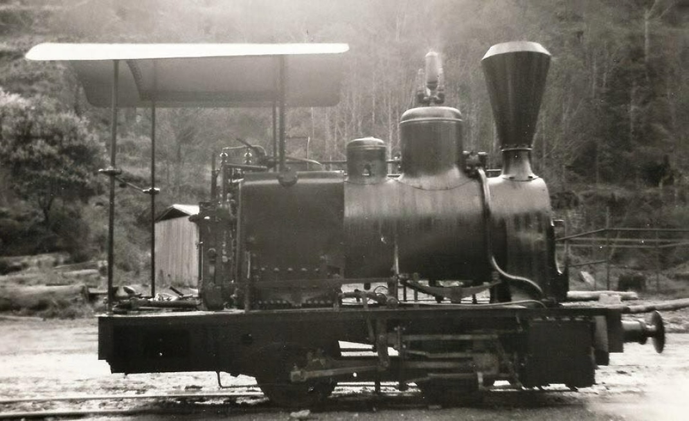
site/assets/narrow-gauge-steam-locomotive-with-short-rounded.jpg
