rytsh/tren/site/assets/nice-neat-garden-railway-trackwork.jpg

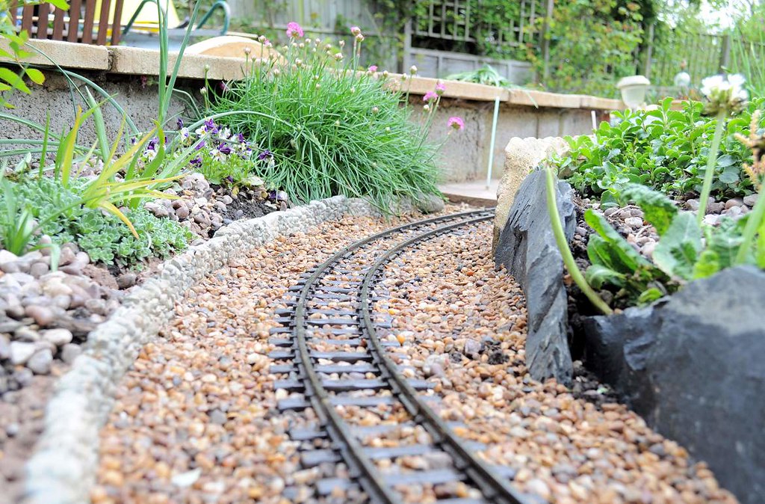
site/assets/nice-neat-garden-railway-trackwork.jpg
