rytsh/tren/site/assets/preserved-narrow-gauge-steam-engine-de-jhangeli.jpg

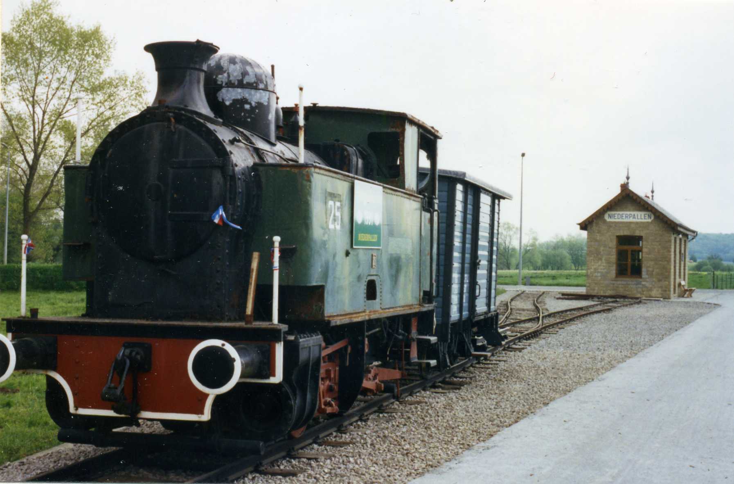
site/assets/preserved-narrow-gauge-steam-engine-de-jhangeli.jpg
