rytsh/tren/site/assets/trainfest-2024-024-wisconsin-garden-railway-society.jpg

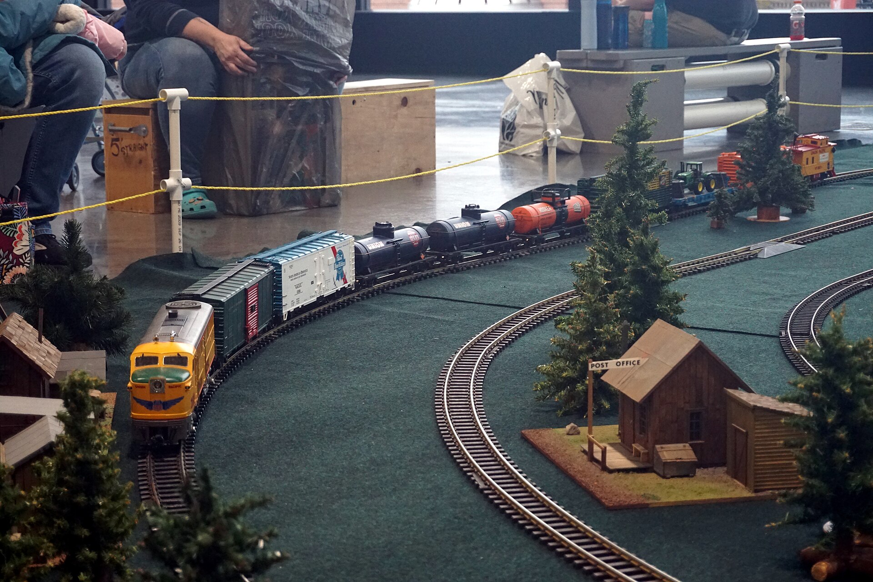
site/assets/trainfest-2024-024-wisconsin-garden-railway-society.jpg
