rytsh/tren/site/assets/treibrader-kuppelstangen-der-db-01-1063-braunschweig.jpg

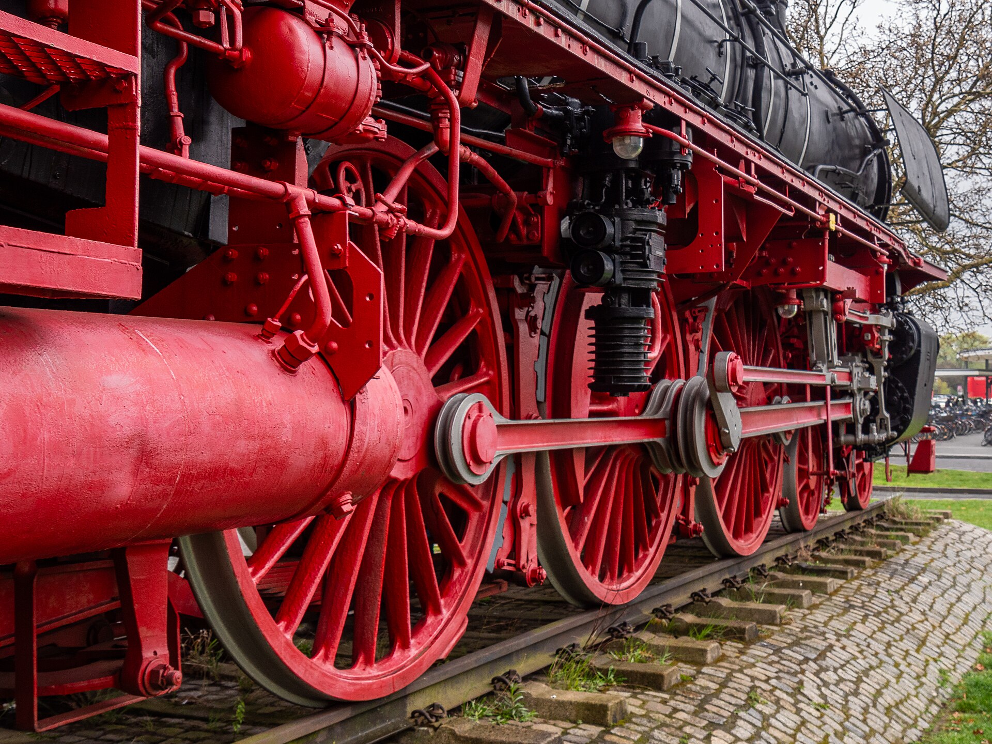
site/assets/treibrader-kuppelstangen-der-db-01-1063-braunschweig.jpg
