rytsh/tren/site/assets/types-of-steam-locomotive-engraving.webp

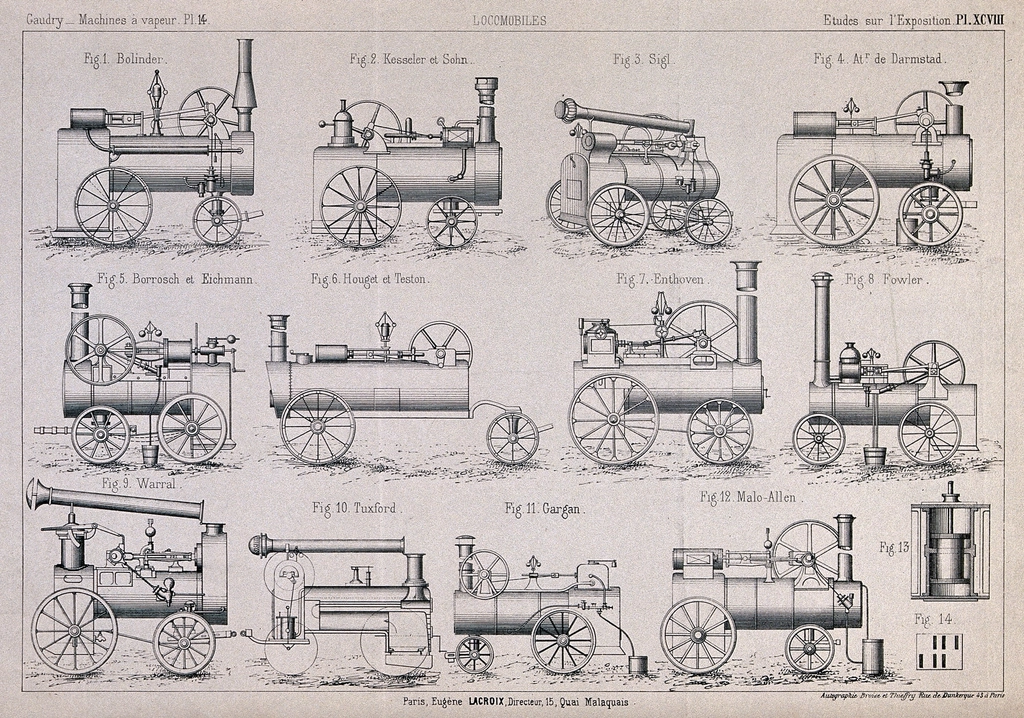
site/assets/types-of-steam-locomotive-engraving.webp
