rytsh/tren/cad/out/3mf/sarj_istasyon_yerinde.3mf

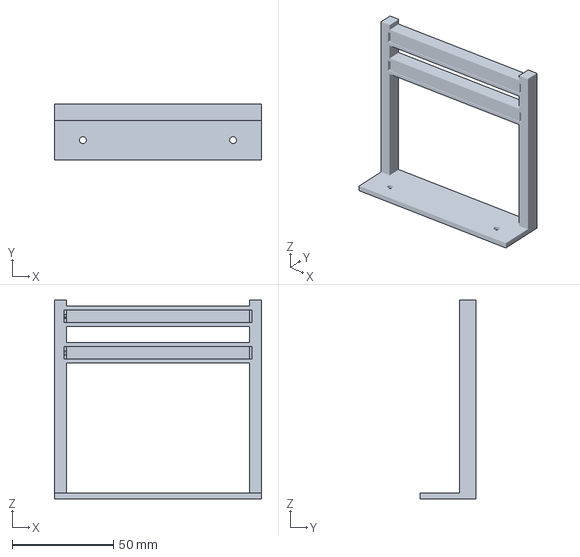
[picture p58: CAD file, 2026-11-05]
cad/out/3mf/sarj_istasyon_yerinde.3mf
102.0 x 27.5 x 98.0 mm
