rytsh/tren/cad/out/step/radar250_montaj.step

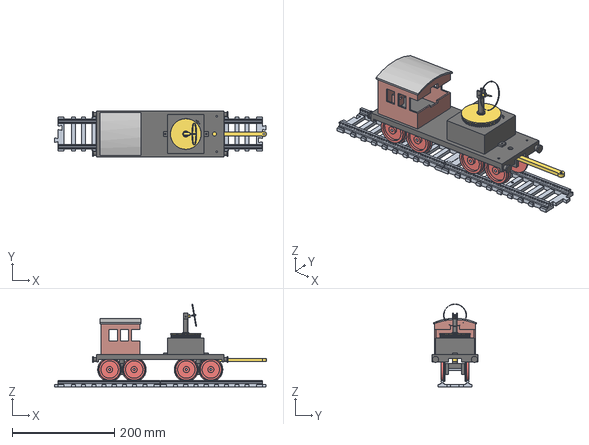
[picture p59: CAD file, 2026-11-06]
cad/out/step/radar250_montaj.step
415.0 x 90.0 x 162.2 mm
