rytsh/tren/cad/out/step/radar_cati.step

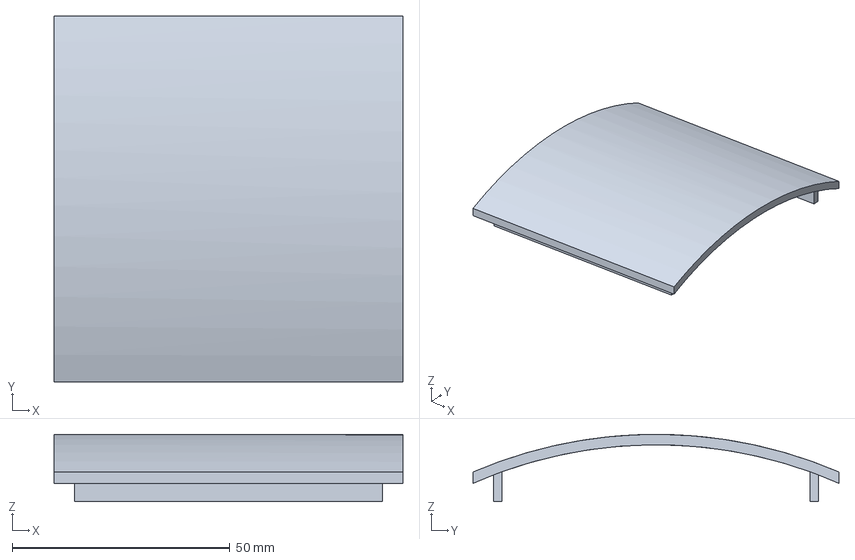
[picture p60: CAD file, 2026-11-06]
cad/out/step/radar_cati.step
80.0 x 84.0 x 15.4 mm
