rytsh/tren/cad/out/step/gozlem_cati.step

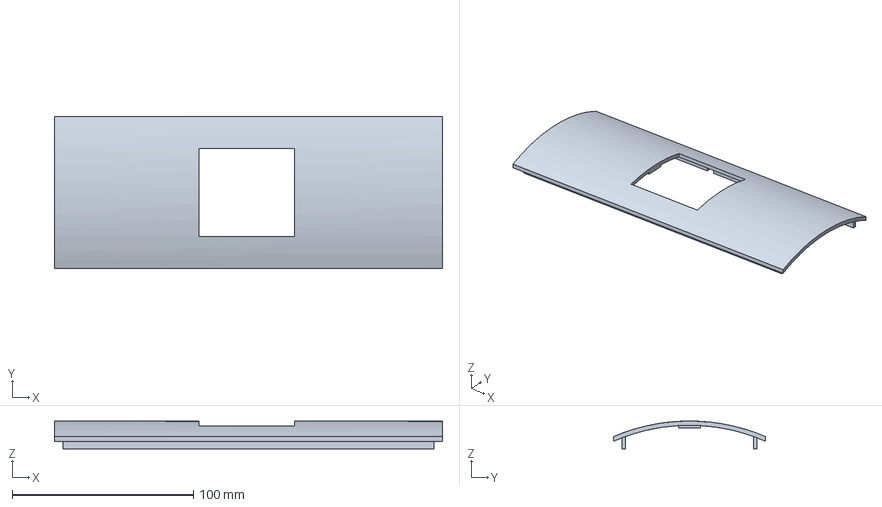
[picture p61: CAD file, 2026-11-06]
cad/out/step/gozlem_cati.step
214.0 x 84.0 x 15.4 mm
