rytsh/tren/cad/out/step/enerji_govde.step

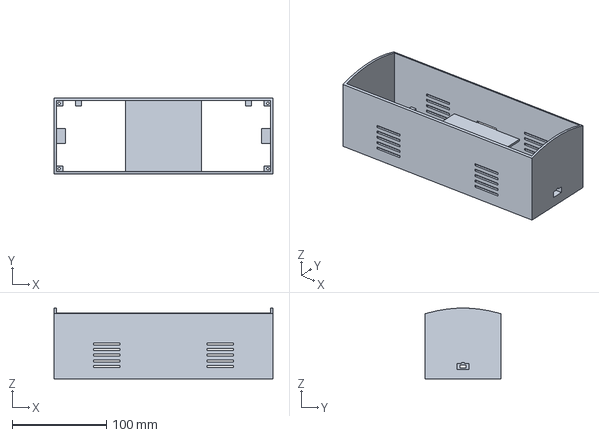
[picture p62: CAD file, 2026-11-06]
cad/out/step/enerji_govde.step
232.0 x 80.0 x 74.9 mm
