rytsh/tren/cad/out/step/yolcu_cati.step

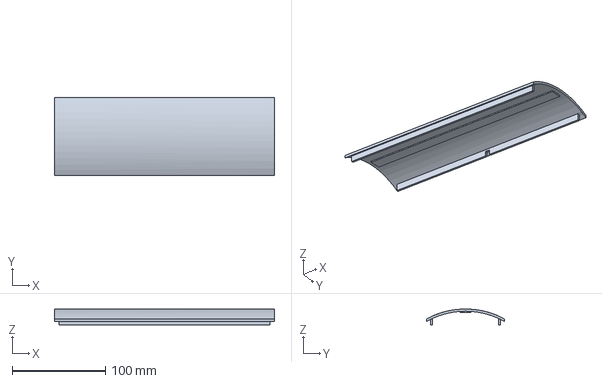
[picture p63: CAD file, 2026-11-06]
cad/out/step/yolcu_cati.step
236.0 x 84.0 x 17.1 mm
