rytsh/tren/cad/out/step/ses250_montaj.step

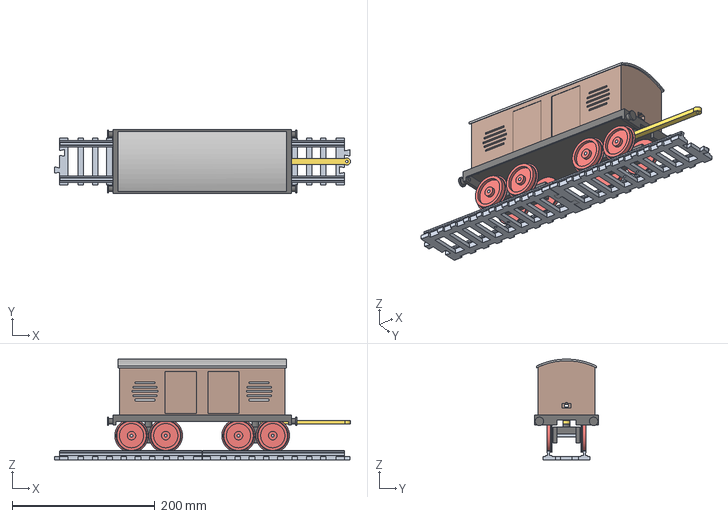
[picture p64: CAD file, 2026-11-06]
cad/out/step/ses250_montaj.step
415.0 x 90.0 x 141.4 mm
