rytsh/tren/cad/out/step/radar_kabin.step

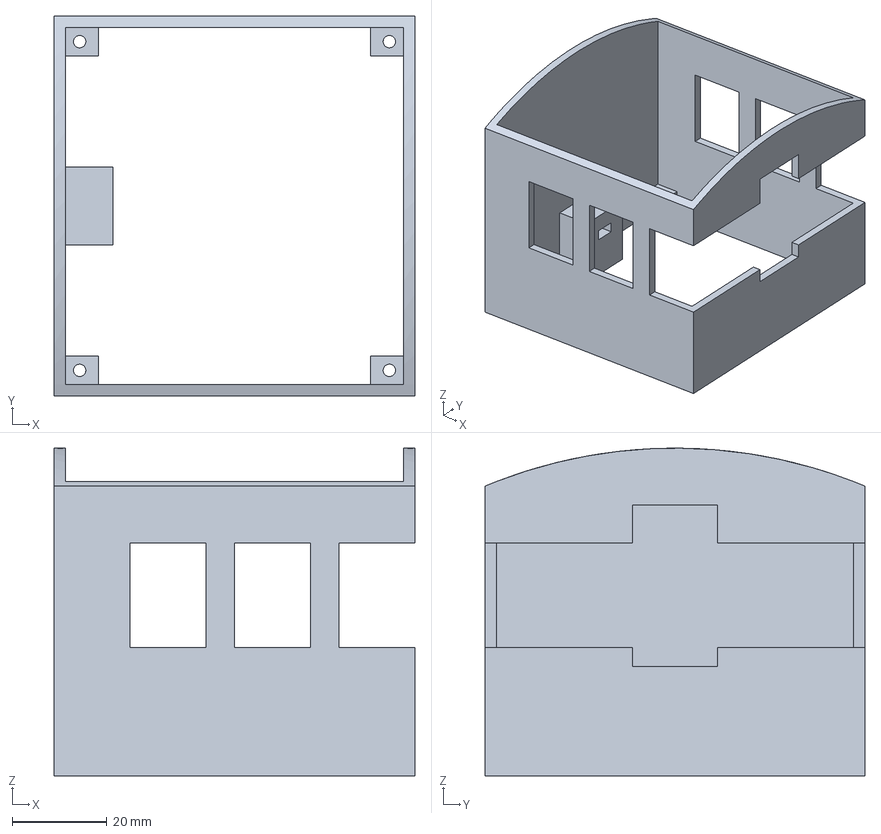
[picture p65: CAD file, 2026-11-06]
cad/out/step/radar_kabin.step
76.0 x 80.0 x 69.0 mm
