rytsh/tren/cad/out/step/gozlem_kubbe.step

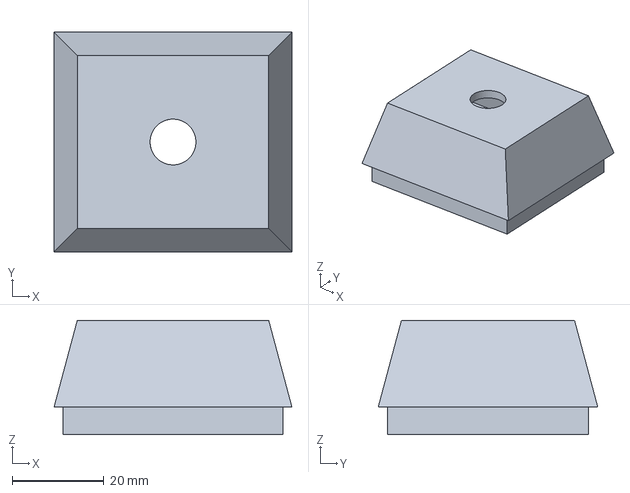
[picture p66: CAD file, 2026-11-06]
cad/out/step/gozlem_kubbe.step
52.0 x 48.0 x 25.0 mm
