rytsh/tren/cad/out/step/gozlem_govde.step

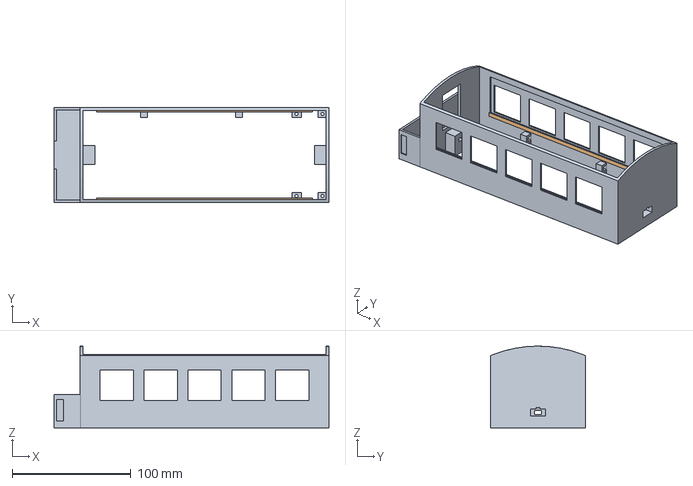
[picture p67: CAD file, 2026-11-06]
cad/out/step/gozlem_govde.step
232.0 x 80.0 x 69.0 mm
