rytsh/tren/cad/out/step/enerji250_montaj.step

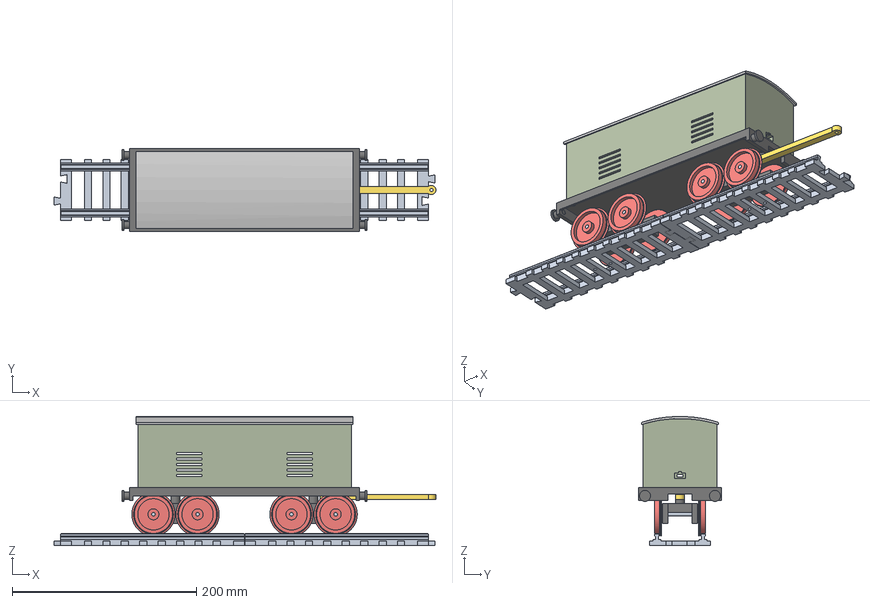
[picture p68: CAD file, 2026-11-06]
cad/out/step/enerji250_montaj.step
415.0 x 90.0 x 140.4 mm
