rytsh/tren/cad/out/step/yolcu_govde.step

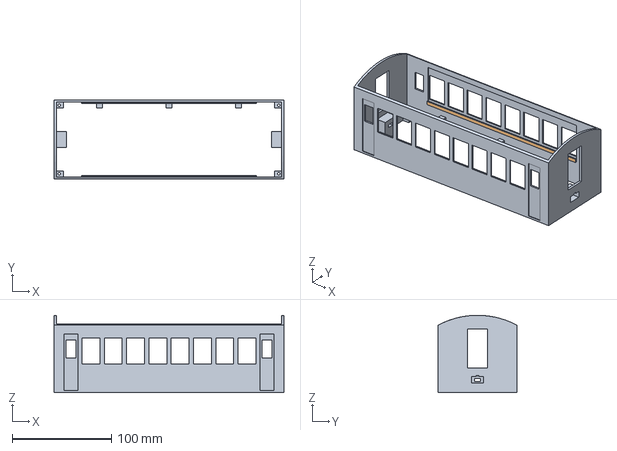
[picture p69: CAD file, 2026-11-06]
cad/out/step/yolcu_govde.step
232.0 x 80.0 x 78.0 mm
