rytsh/tren/cad/out/step/radar_kaide.step

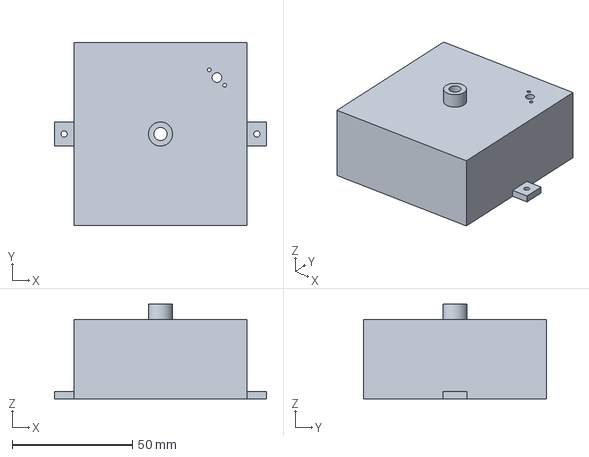
[picture p70: CAD file, 2026-11-06]
cad/out/step/radar_kaide.step
88.0 x 76.0 x 39.3 mm
