rytsh/tren/cad/out/step/radar_anten.step

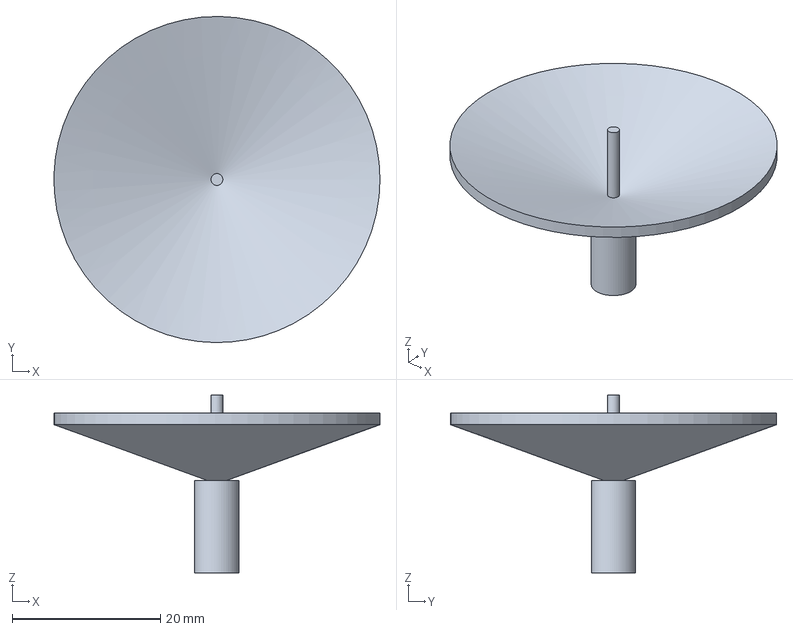
[picture p71: CAD file, 2026-11-06]
cad/out/step/radar_anten.step
44.0 x 44.0 x 24.0 mm
