rytsh/tren/cad/out/step/ses_govde.step

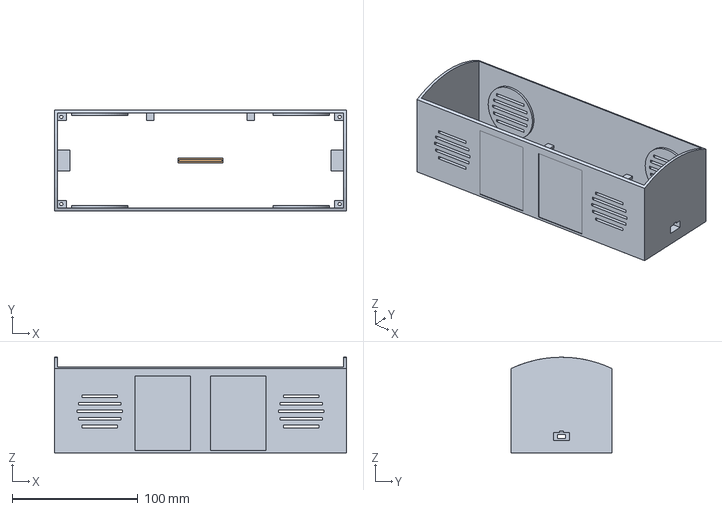
[picture p72: CAD file, 2026-11-06]
cad/out/step/ses_govde.step
232.0 x 80.0 x 76.0 mm
