rytsh/tren/cad/out/step/yolcu250_montaj.step

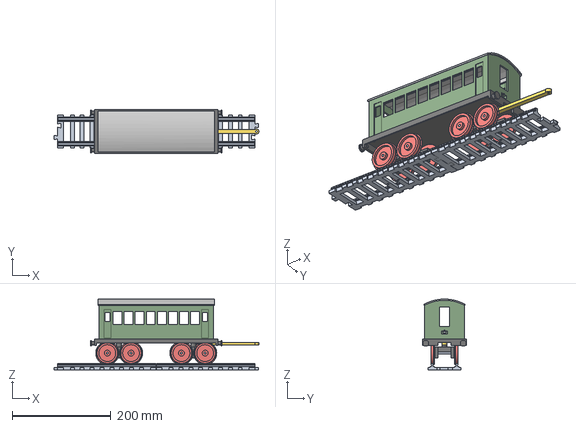
[picture p73: CAD file, 2026-11-06]
cad/out/step/yolcu250_montaj.step
415.0 x 90.0 x 143.4 mm
