rytsh/tren/cad/out/step/radar_tabla.step

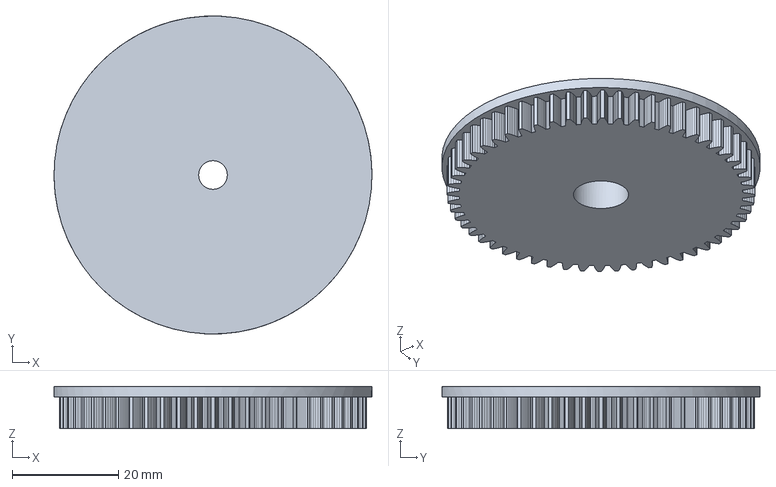
[picture p74: CAD file, 2026-11-06]
cad/out/step/radar_tabla.step
60.0 x 59.9 x 8.00 mm
