rytsh/tren/cad/out/step/gozlem250_montaj.step

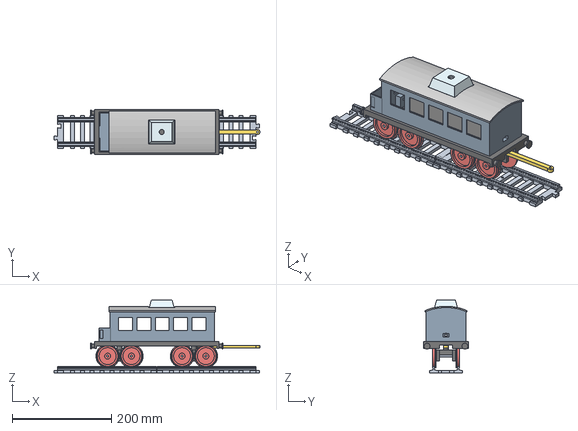
[picture p75: CAD file, 2026-11-06]
cad/out/step/gozlem250_montaj.step
415.0 x 90.0 x 147.0 mm
