rytsh/tren/cad/out/step/radar_direk.step

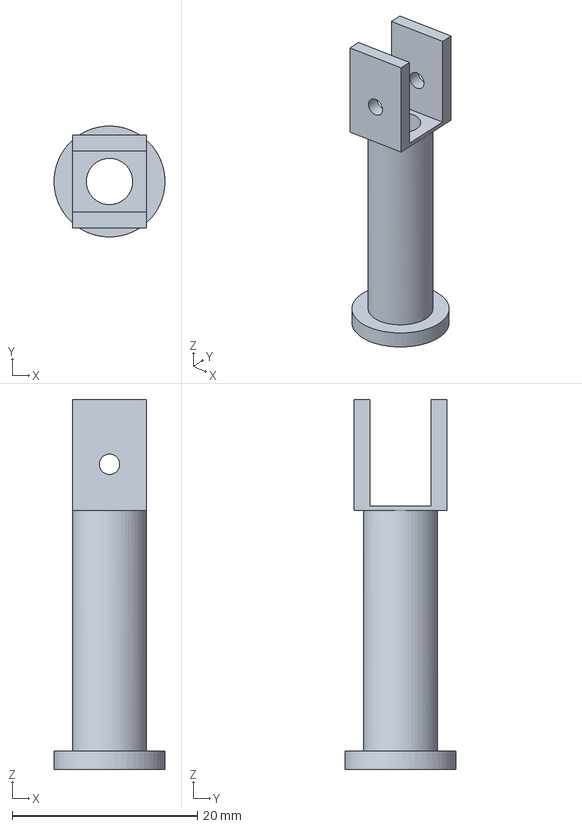
[picture p76: CAD file, 2026-11-06]
cad/out/step/radar_direk.step
12.0 x 12.0 x 40.0 mm
