rytsh/tren/cad/out/step/ses_cati.step

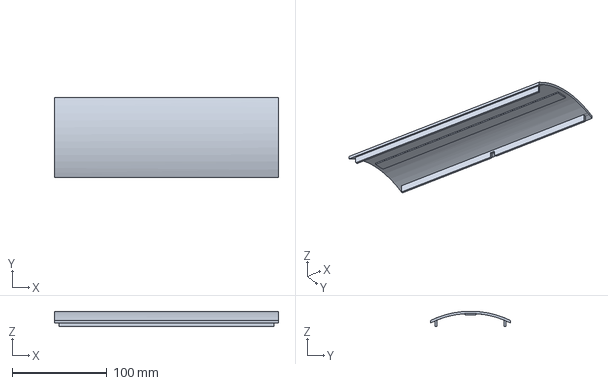
[picture p77: CAD file, 2026-11-06]
cad/out/step/ses_cati.step
236.0 x 84.0 x 16.2 mm
