rytsh/tren/cad/out/step/enerji_cati.step

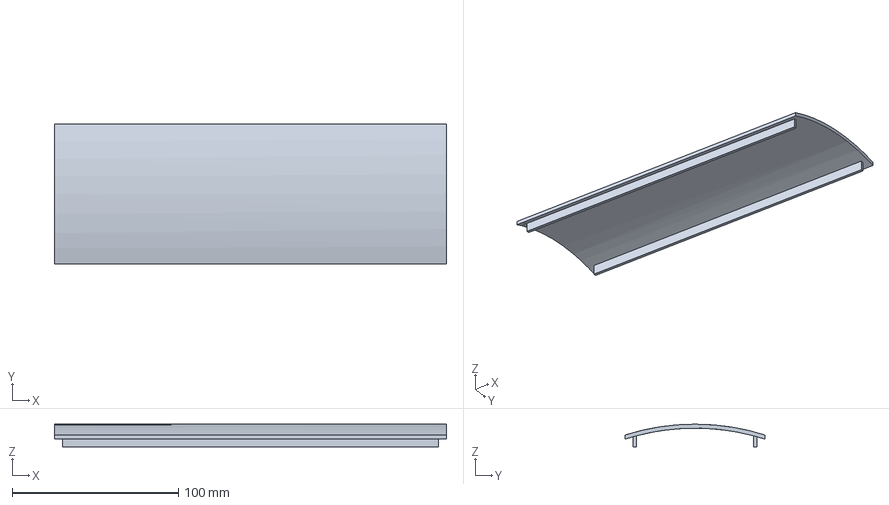
[picture p78: CAD file, 2026-11-06]
cad/out/step/enerji_cati.step
236.0 x 84.0 x 13.7 mm
