rytsh/tren/cad/out/step/tender_montaj.step

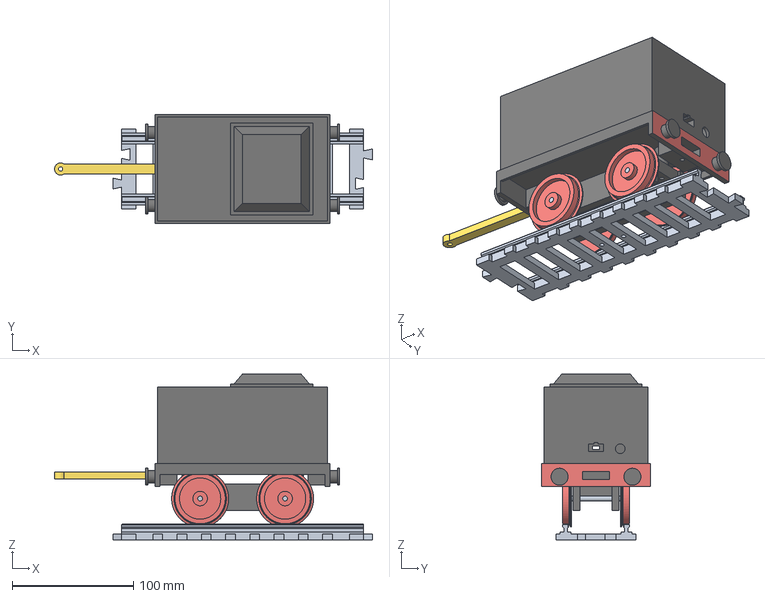
[picture p79: CAD file, 2026-11-06]
cad/out/step/tender_montaj.step
262.0 x 90.0 x 136.5 mm
