rytsh/tren/cad/out/step/tender_depo.step

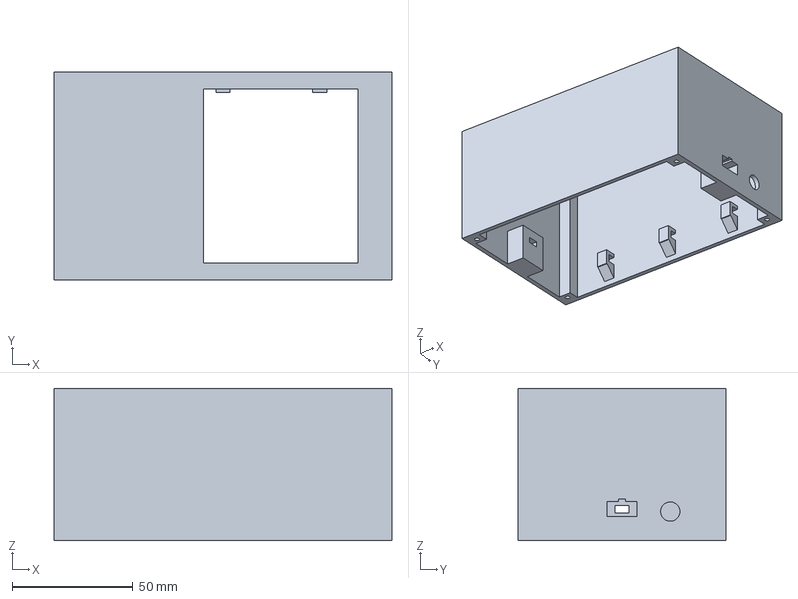
[picture p80: CAD file, 2026-11-06]
cad/out/step/tender_depo.step
140.0 x 86.0 x 63.0 mm
