rytsh/tren/cad/out/step/sasi250_montaj.step

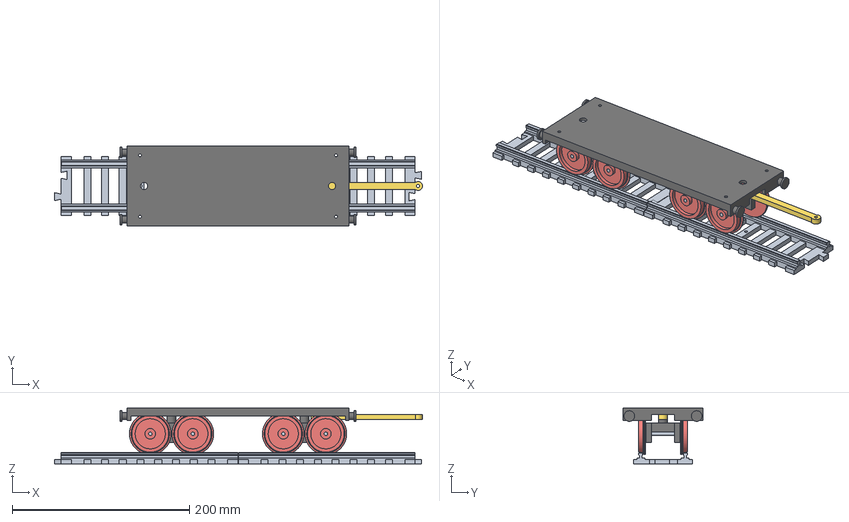
[picture p82: CAD file, 2026-11-05]
cad/out/step/sasi250_montaj.step
415.0 x 90.0 x 63.0 mm
