rytsh/tren/cad/out/step/sarj250_montaj.step

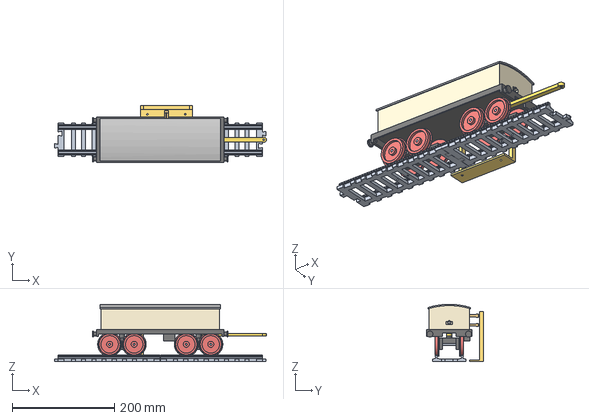
[picture p83: CAD file, 2026-11-05]
cad/out/step/sarj250_montaj.step
415.0 x 112.5 x 112.4 mm
