rytsh/tren/cad/out/step/sarj_platform.step

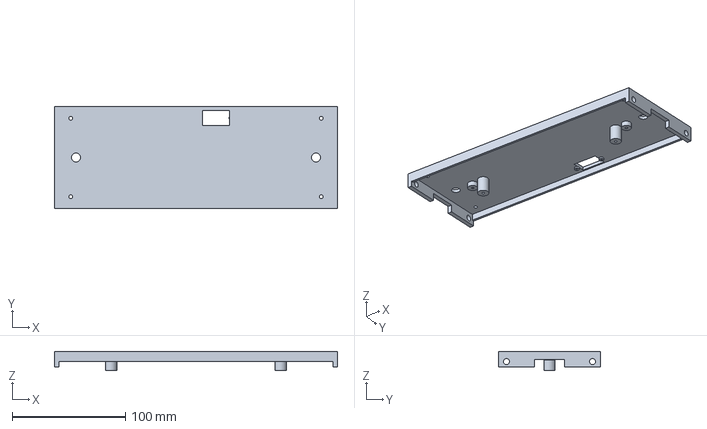
[picture p84: CAD file, 2026-11-05]
cad/out/step/sarj_platform.step
250.0 x 90.0 x 17.0 mm
