rytsh/tren/cad/out/step/ceki_kolu_tender_250.step

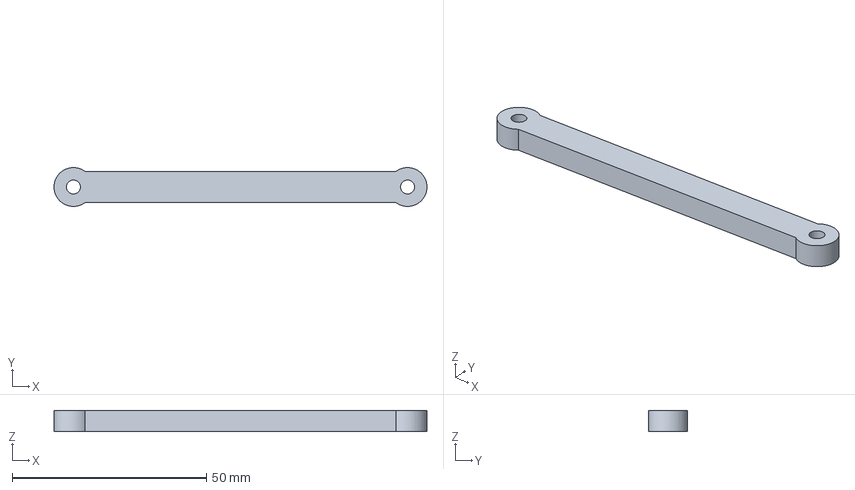
[picture p85: CAD file, 2026-11-05]
cad/out/step/ceki_kolu_tender_250.step
96.0 x 9.99 x 5.50 mm
