rytsh/tren/cad/out/step/sarj_govde.step

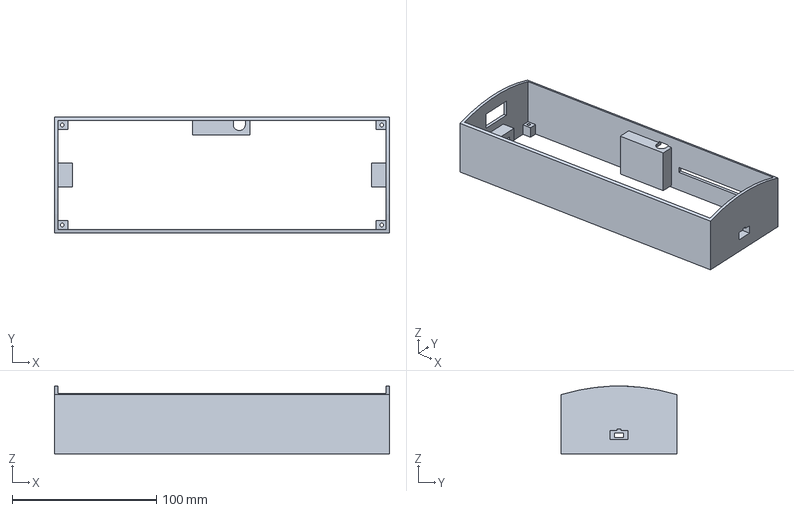
[picture p86: CAD file, 2026-11-05]
cad/out/step/sarj_govde.step
232.0 x 80.0 x 46.9 mm
