rytsh/tren/cad/out/step/sarj_istasyon.step

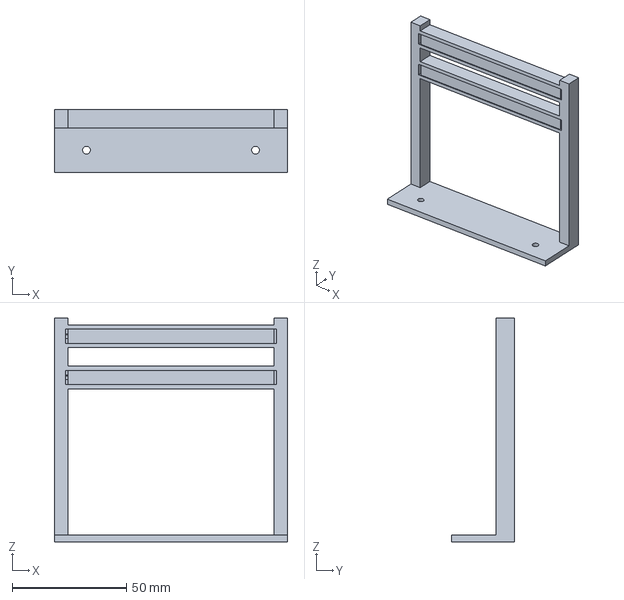
[picture p87: CAD file, 2026-11-05]
cad/out/step/sarj_istasyon.step
102.0 x 27.5 x 98.0 mm
