rytsh/tren/cad/out/step/tampon_250.step

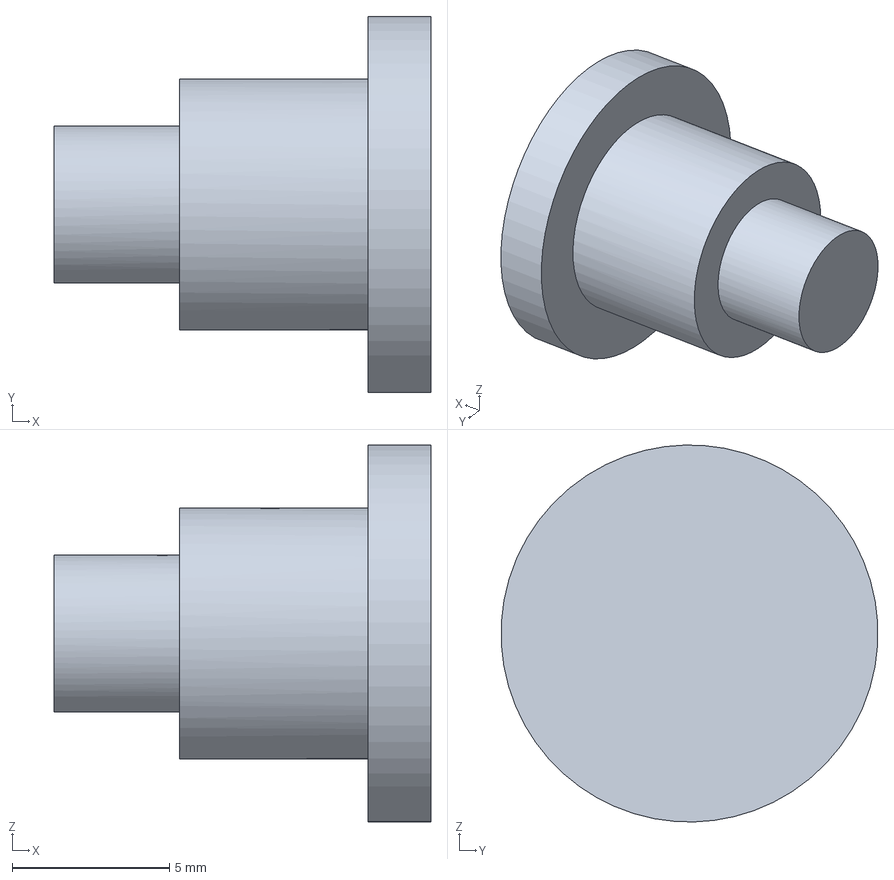
[picture p88: CAD file, 2026-11-05]
cad/out/step/tampon_250.step
12.0 x 12.0 x 12.0 mm
