rytsh/tren/cad/out/step/sarj_kol.step

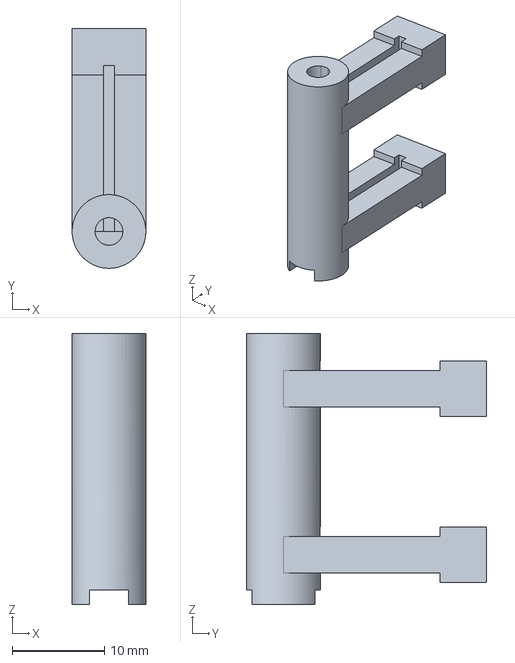
[picture p89: CAD file, 2026-11-05]
cad/out/step/sarj_kol.step
8.00 x 26.0 x 29.4 mm
