rytsh/tren/cad/out/step/vagon_govde.step

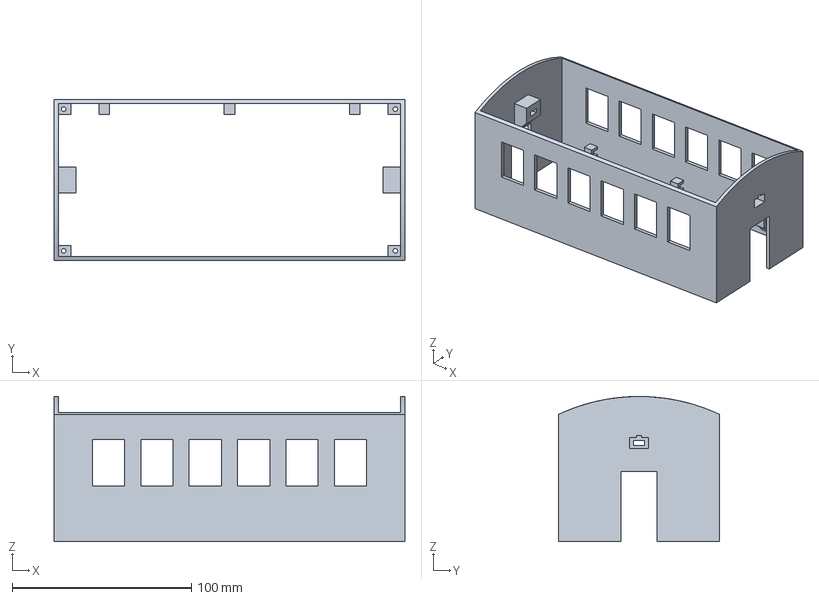
[picture p90: CAD file, 2026-11-04]
cad/out/step/vagon_govde.step
196.0 x 90.0 x 81.0 mm
