rytsh/tren/cad/out/step/vagon_cati.step

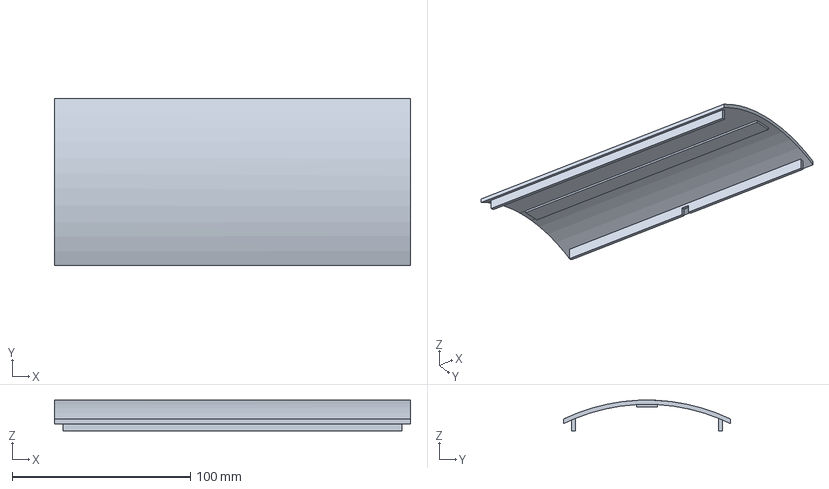
[picture p91: CAD file, 2026-11-04]
cad/out/step/vagon_cati.step
200.0 x 94.0 x 17.3 mm
