rytsh/tren/cad/out/step/vagon_montaj.step

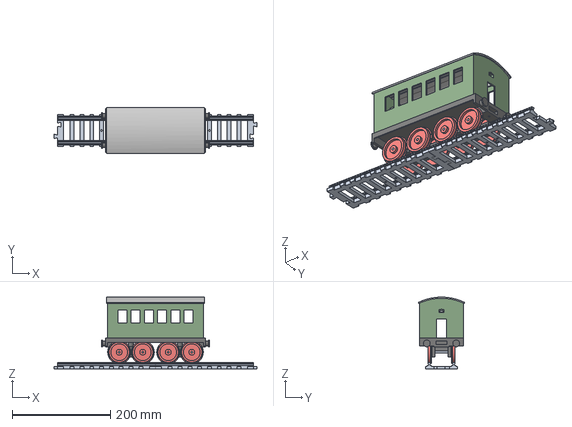
[picture p92: CAD file, 2026-11-04]
cad/out/step/vagon_montaj.step
414.0 x 94.0 x 146.4 mm
