rytsh/tren/cad/out/step/sasi_test_040.step

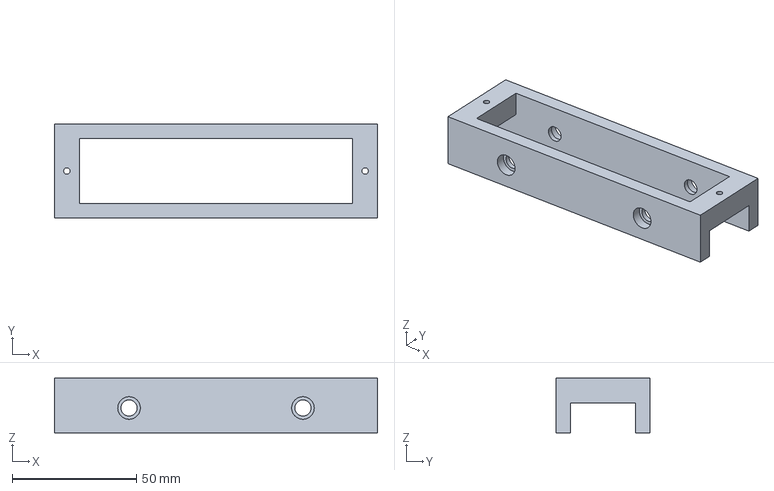
[picture p93: CAD file, 2026-11-04]
cad/out/step/sasi_test_040.step
130.0 x 38.0 x 22.0 mm
