rytsh/tren/cad/out/step/ceki_kolu.step

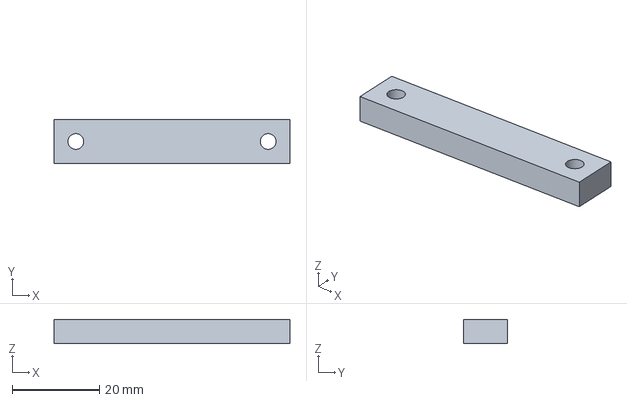
[picture p94: CAD file, 2026-11-04]
cad/out/step/ceki_kolu.step
54.0 x 10.0 x 5.50 mm
