rytsh/tren/cad/out/step/lok_platform_arka.step

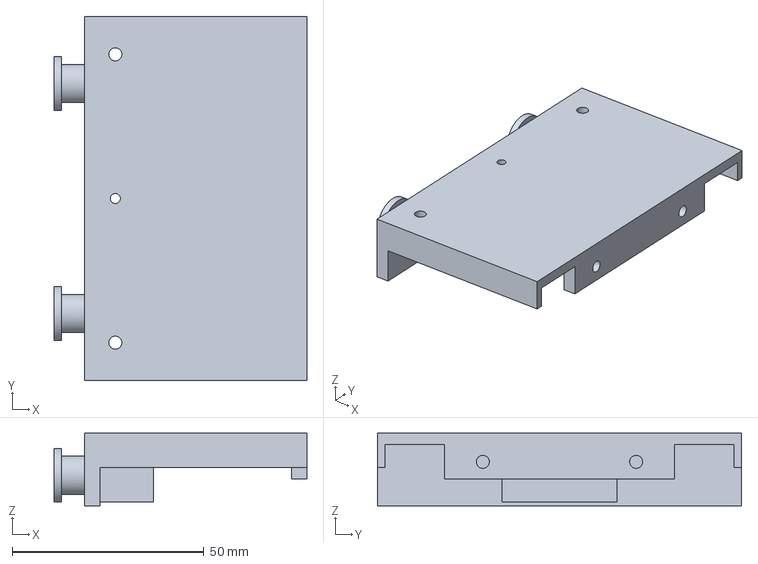
[picture p95: CAD file, 2026-11-04]
cad/out/step/lok_platform_arka.step
66.0 x 95.0 x 19.0 mm
