rytsh/tren/cad/out/step/lok_kazan.step

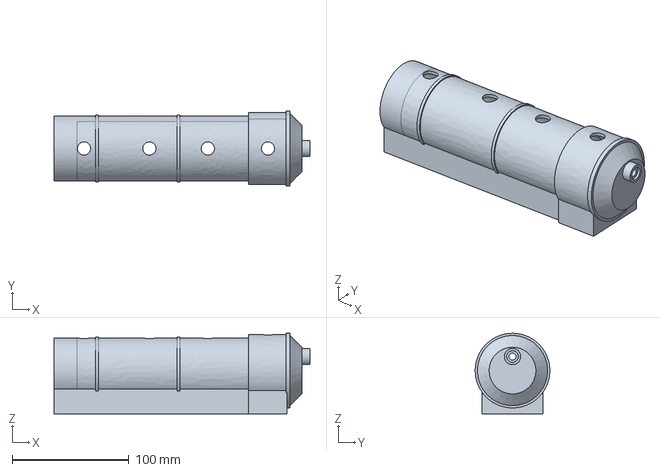
[picture p96: CAD file, 2026-11-04]
cad/out/step/lok_kazan.step
219.2 x 63.9 x 69.0 mm
