rytsh/tren/cad/out/step/tender_sasi.step

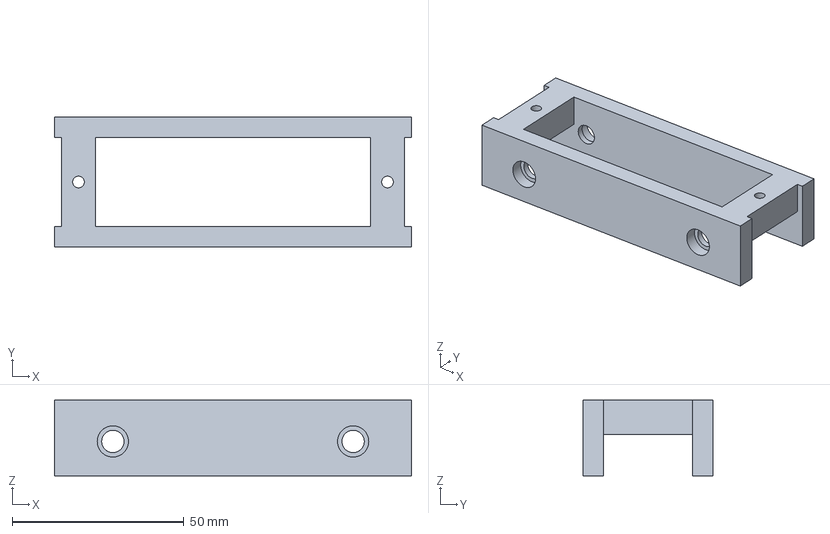
[picture p97: CAD file, 2026-11-04]
cad/out/step/tender_sasi.step
104.0 x 38.0 x 22.0 mm
