rytsh/tren/cad/out/step/lok_buhar_domu.step

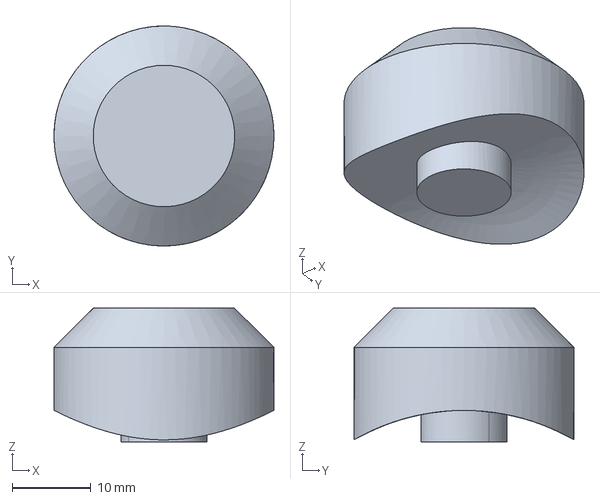
[picture p98: CAD file, 2026-11-04]
cad/out/step/lok_buhar_domu.step
28.0 x 28.0 x 17.0 mm
