rytsh/tren/cad/out/step/lok_emniyet_ventili.step

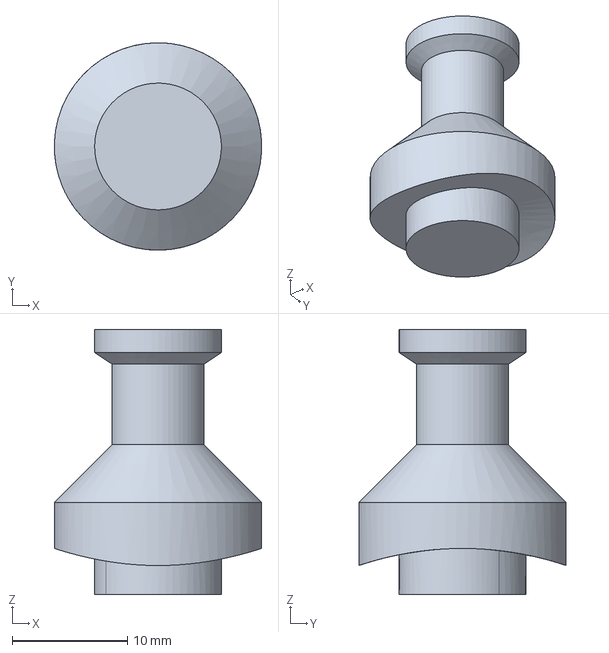
[picture p99: CAD file, 2026-11-04]
cad/out/step/lok_emniyet_ventili.step
18.0 x 18.0 x 23.0 mm
