rytsh/tren/cad/out/step/vagon_boji.step

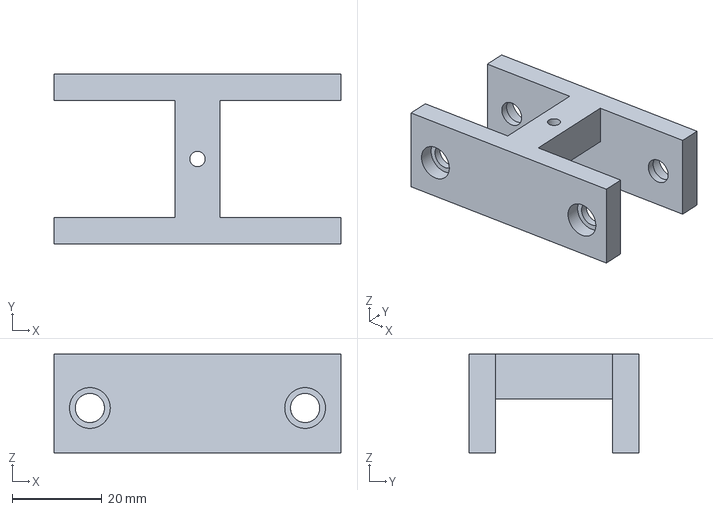
[picture p100: CAD file, 2026-11-04]
cad/out/step/vagon_boji.step
64.0 x 38.0 x 22.0 mm
