rytsh/tren/cad/out/step/vagon_platform.step

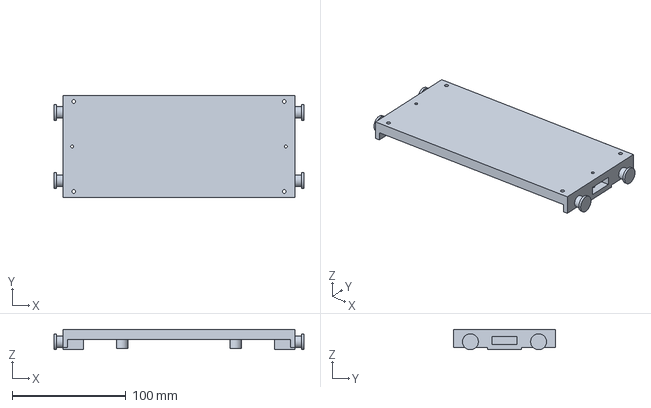
[picture p101: CAD file, 2026-11-04]
cad/out/step/vagon_platform.step
220.0 x 90.0 x 18.0 mm
