rytsh/tren/cad/out/step/lok_platform_on.step

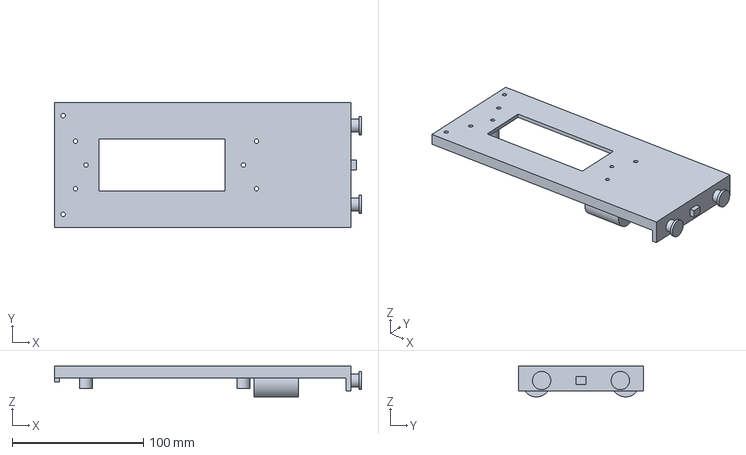
[picture p102: CAD file, 2026-11-04]
cad/out/step/lok_platform_on.step
234.0 x 95.0 x 23.5 mm
