rytsh/tren/cad/out/step/tender_platform.step

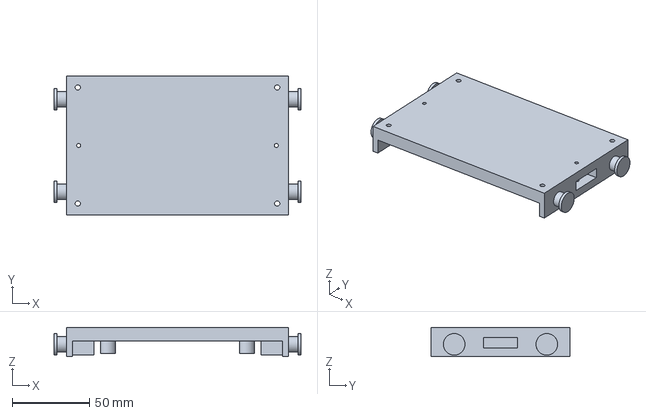
[picture p103: CAD file, 2026-11-04]
cad/out/step/tender_platform.step
160.0 x 90.0 x 19.0 mm
