rytsh/tren/cad/out/step/lok_kum_domu.step

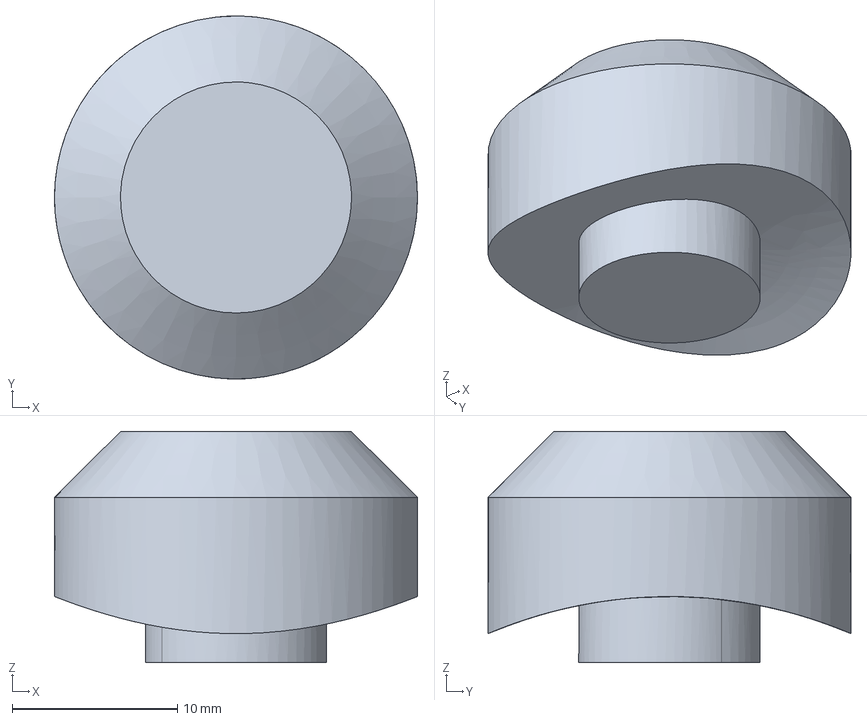
[picture p104: CAD file, 2026-11-04]
cad/out/step/lok_kum_domu.step
22.0 x 22.0 x 14.0 mm
