rytsh/tren/cad/out/step/lok_baca.step

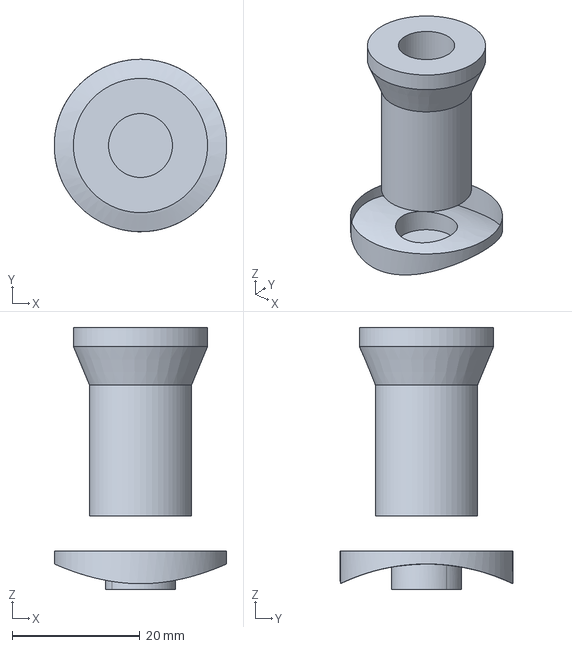
[picture p105: CAD file, 2026-11-04]
cad/out/step/lok_baca.step
27.0 x 27.0 x 41.0 mm
