rytsh/tren/cad/out/step/lok_kabin.step

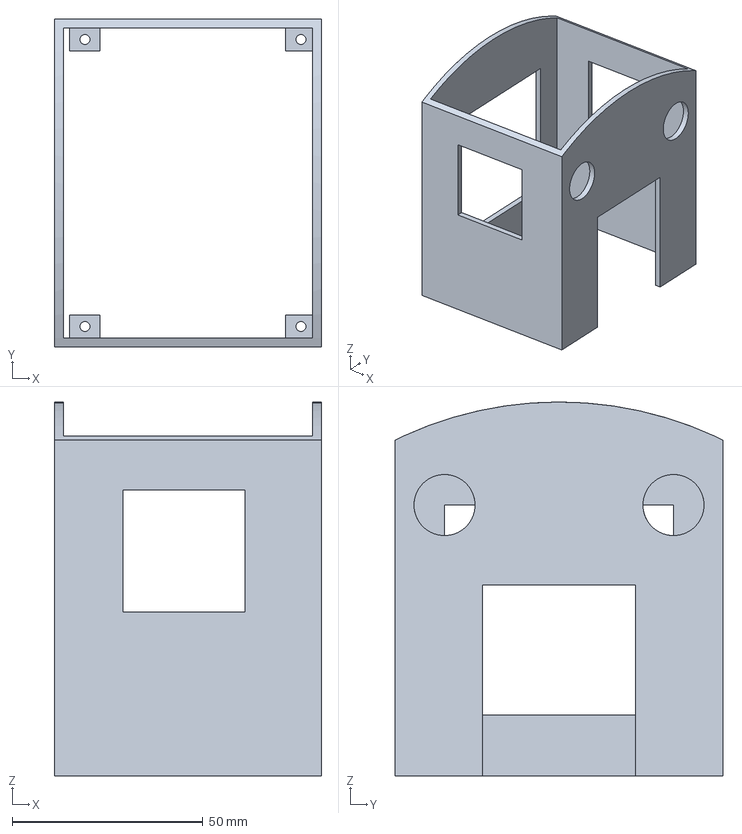
[picture p106: CAD file, 2026-11-04]
cad/out/step/lok_kabin.step
70.0 x 86.0 x 98.0 mm
