rytsh/tren/cad/out/step/lok_kabin_cati.step

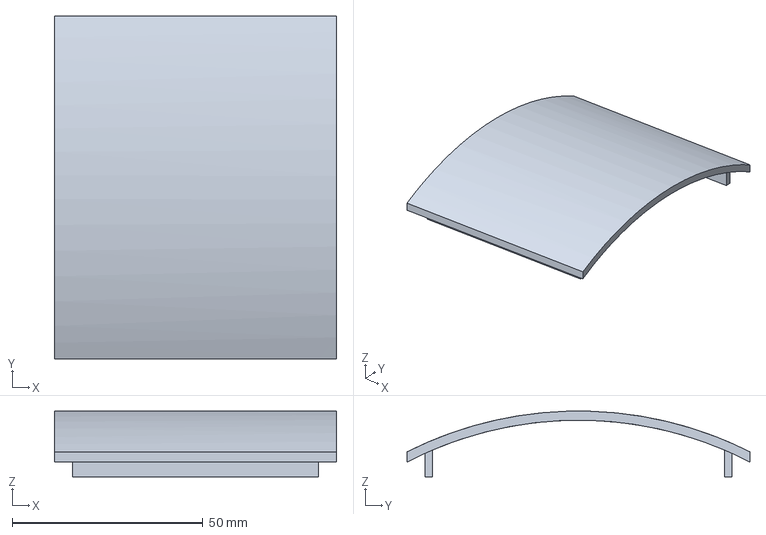
[picture p107: CAD file, 2026-11-04]
cad/out/step/lok_kabin_cati.step
74.0 x 90.0 x 17.2 mm
