rytsh/tren/cad/out/step/tender_kapak.step

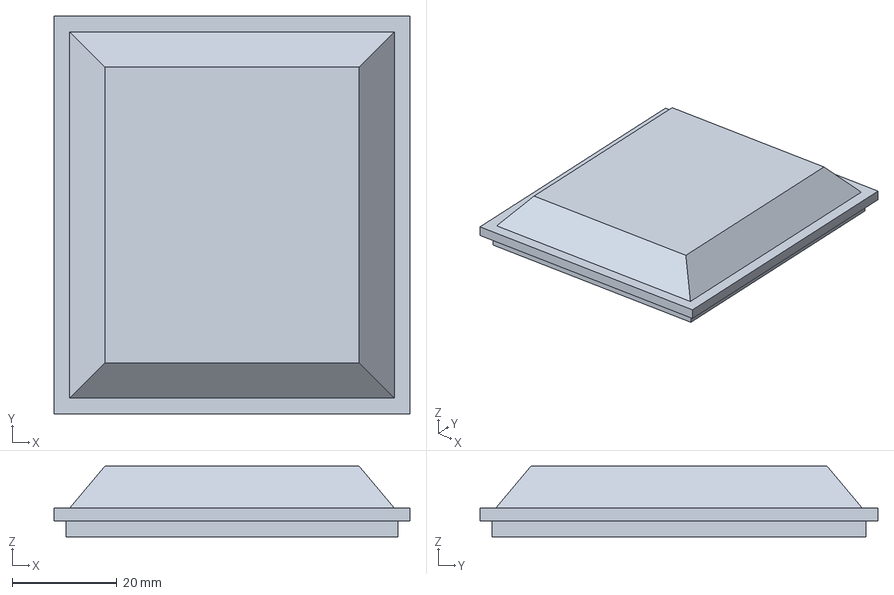
[picture p108: CAD file, 2026-11-04]
cad/out/step/tender_kapak.step
68.0 x 76.0 x 13.5 mm
