rytsh/tren/cad/out/step/pul_aks_4mm.step

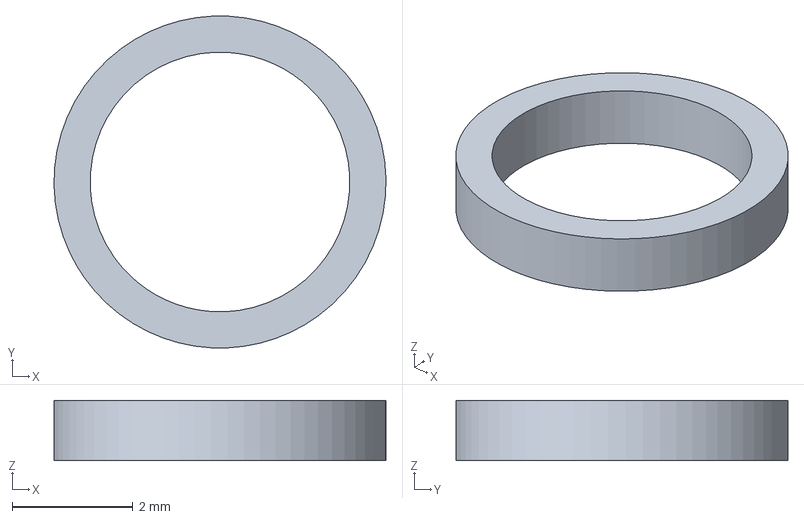
[picture p109: CAD file, 2026-11-04]
cad/out/step/pul_aks_4mm.step
5.50 x 5.49 x 1.00 mm
