rytsh/tren/cad/out/step/ray_duz_200.step

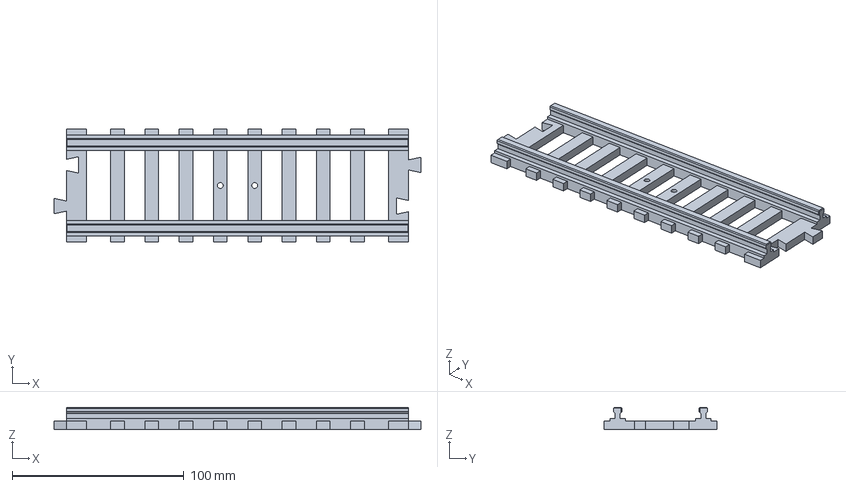
[picture p110: CAD file, 2026-11-04]
cad/out/step/ray_duz_200.step
214.0 x 66.0 x 13.0 mm
