rytsh/tren/cad/out/step/karsi_disli_m1_z30.step

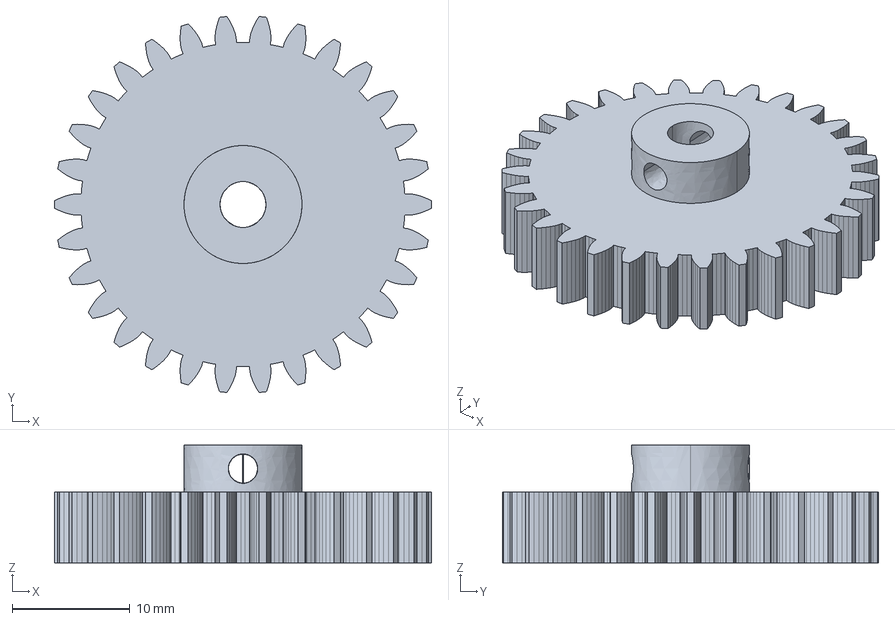
[picture p111: CAD file, 2026-11-04]
cad/out/step/karsi_disli_m1_z30.step
32.0 x 31.9 x 10.0 mm
