rytsh/tren/cad/out/step/sasi_motorlu_040.step

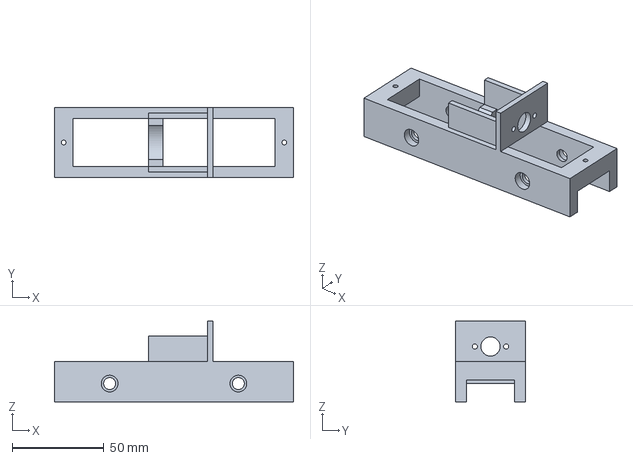
[picture p112: CAD file, 2026-11-04]
cad/out/step/sasi_motorlu_040.step
130.0 x 38.0 x 44.0 mm
