rytsh/tren/cad/out/step/tekerlek_test_d42.step

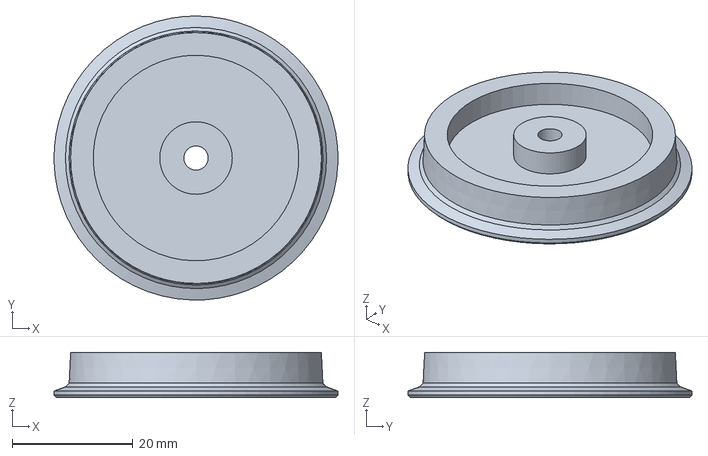
[picture p113: CAD file, 2026-11-04]
cad/out/step/tekerlek_test_d42.step
47.0 x 47.0 x 7.50 mm
