rytsh/tren/cad/out/step/montaj_kontrol.step

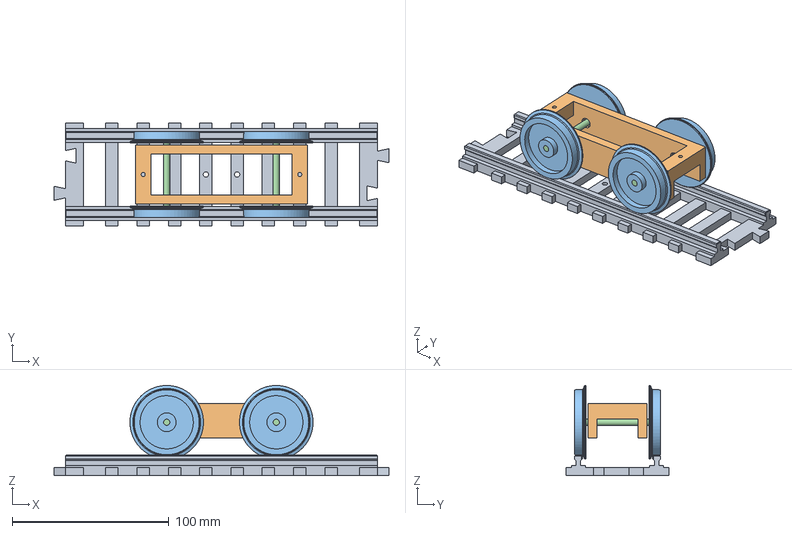
[picture p114: CAD file, 2026-11-04]
cad/out/step/montaj_kontrol.step
214.0 x 66.0 x 57.5 mm
