rytsh/tren/cad/out/step/ray_viraj_r750_15.step

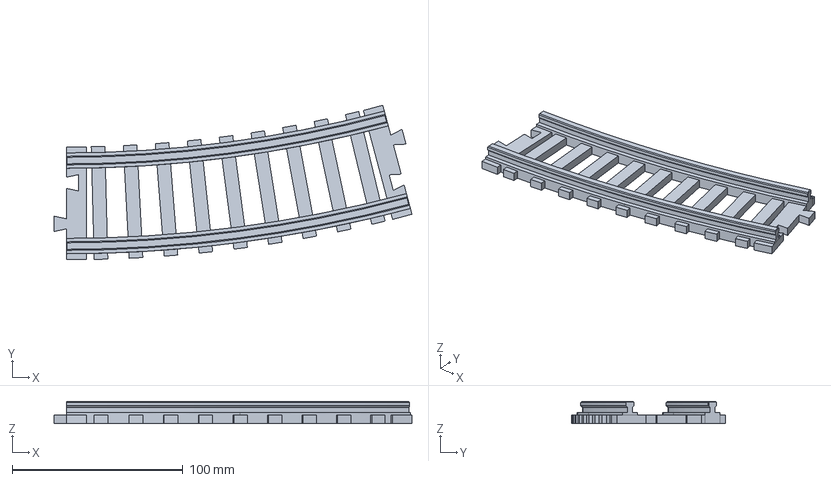
[picture p115: CAD file, 2026-11-04]
cad/out/step/ray_viraj_r750_15.step
209.4 x 90.4 x 13.0 mm
