rytsh/tren/cad/out/step/sonsuz_vida_m1.step

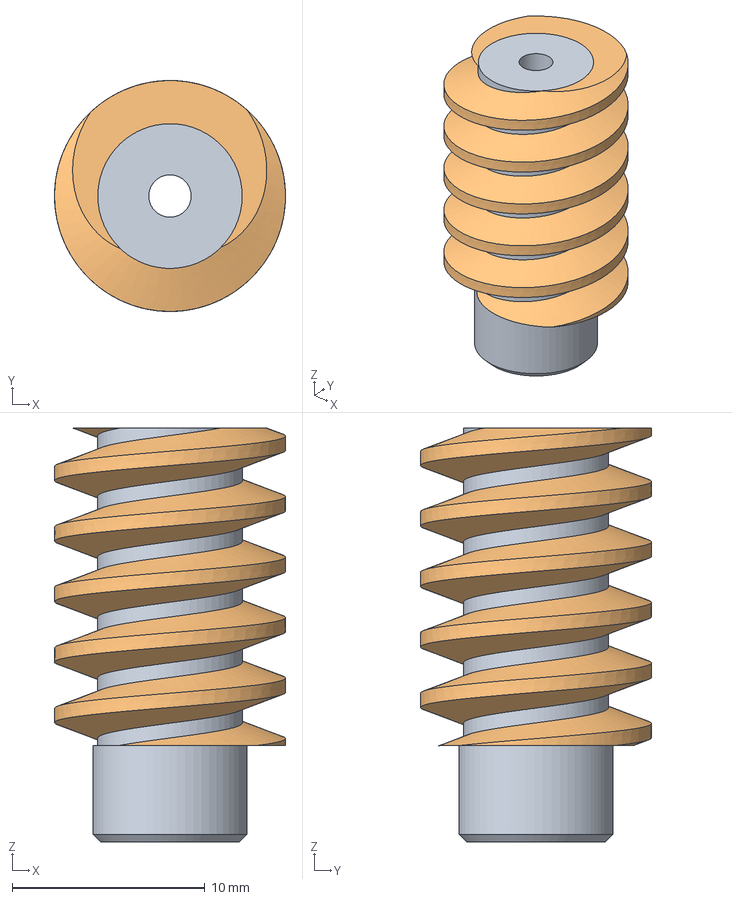
[picture p116: CAD file, 2026-11-04]
cad/out/step/sonsuz_vida_m1.step
12.0 x 12.0 x 21.5 mm
