rytsh/tren/cad/out/step/tolerans_kuponu.step

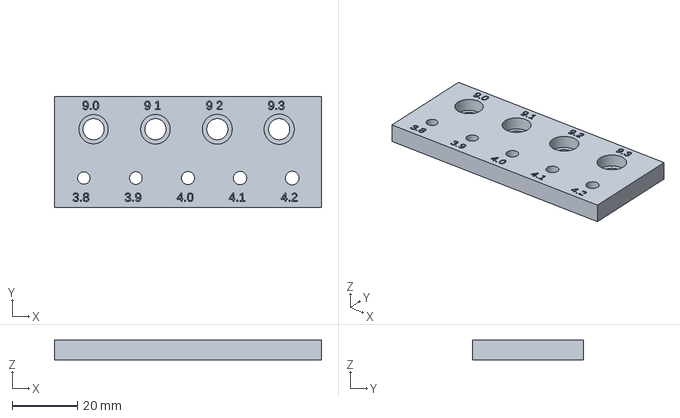
[picture p117: CAD file, 2026-11-04]
cad/out/step/tolerans_kuponu.step
82.0 x 34.0 x 6.00 mm
