rytsh/tren/cad/out/step/montaj_motorlu.step

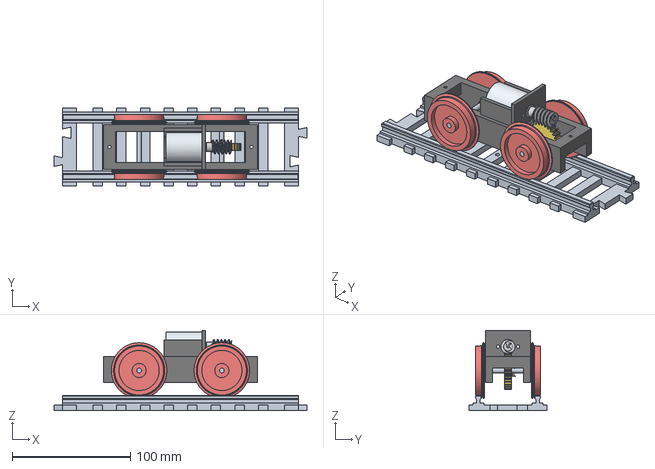
[picture p118: CAD file, 2026-11-04]
cad/out/step/montaj_motorlu.step
214.0 x 66.0 x 68.0 mm
