rytsh/tren/(list of files, cad)

Other CAD files:
cad/out/step/vagon_platform_250.step
cad/out/step/sarj_cati.step
cad/out/step/lokomotif_montaj.step
cad/out/3mf/ceki_kolu.3mf
cad/out/3mf/ceki_kolu_250.3mf
cad/out/3mf/ceki_kolu_tender_250.3mf
cad/out/3mf/enerji250_montaj.3mf
cad/out/3mf/enerji_cati.3mf
cad/out/3mf/enerji_govde.3mf
cad/out/3mf/gozlem250_montaj.3mf
cad/out/3mf/gozlem_cati.3mf
cad/out/3mf/gozlem_govde.3mf
cad/out/3mf/gozlem_kubbe.3mf
cad/out/3mf/karsi_disli_m1_z30.3mf
cad/out/3mf/lok_baca.3mf
cad/out/3mf/lok_buhar_domu.3mf
cad/out/3mf/lok_emniyet_ventili.3mf
cad/out/3mf/lok_kabin.3mf
cad/out/3mf/lok_kabin_cati.3mf
cad/out/3mf/lok_kazan.3mf
cad/out/3mf/lok_kum_domu.3mf
cad/out/3mf/lok_platform_arka.3mf
cad/out/3mf/lok_platform_on.3mf
cad/out/3mf/lokomotif_montaj.3mf
cad/out/3mf/pul_aks_4mm.3mf
cad/out/3mf/radar250_montaj.3mf
cad/out/3mf/radar_anten.3mf
cad/out/3mf/radar_cati.3mf
cad/out/3mf/radar_direk.3mf
cad/out/3mf/radar_kabin.3mf
cad/out/3mf/radar_kaide.3mf
cad/out/3mf/radar_tabla.3mf
cad/out/3mf/ray_duz_200.3mf
cad/out/3mf/ray_viraj_r750_15.3mf
cad/out/3mf/sarj250_montaj.3mf
cad/out/3mf/sarj_cati.3mf
cad/out/3mf/sarj_govde.3mf
cad/out/3mf/sarj_istasyon.3mf
cad/out/3mf/sarj_kol.3mf
cad/out/3mf/sarj_platform.3mf
cad/out/3mf/sasi250_montaj.3mf
cad/out/3mf/sasi_motorlu_040.3mf
cad/out/3mf/sasi_test_040.3mf
cad/out/3mf/ses250_montaj.3mf
cad/out/3mf/ses_cati.3mf
cad/out/3mf/ses_govde.3mf
cad/out/3mf/sonsuz_vida_m1.3mf
cad/out/3mf/tampon_250.3mf
cad/out/3mf/tekerlek_test_d42.3mf
cad/out/3mf/tender_depo.3mf
cad/out/3mf/tender_kapak.3mf
cad/out/3mf/tender_montaj.3mf
cad/out/3mf/tender_platform.3mf
cad/out/3mf/tender_sasi.3mf
cad/out/3mf/tolerans_kuponu.3mf
cad/out/3mf/vagon_boji.3mf
cad/out/3mf/vagon_cati.3mf
cad/out/3mf/vagon_govde.3mf
cad/out/3mf/vagon_montaj.3mf
cad/out/3mf/vagon_platform.3mf
cad/out/3mf/vagon_platform_250.3mf
cad/out/3mf/yolcu250_montaj.3mf
cad/out/3mf/yolcu_cati.3mf
cad/out/3mf/yolcu_govde.3mf
cad/out/stl/ceki_kolu.stl
cad/out/stl/ceki_kolu_250.stl
cad/out/stl/ceki_kolu_tender_250.stl
cad/out/stl/enerji_cati.stl
cad/out/stl/enerji_govde.stl
cad/out/stl/gozlem_cati.stl
cad/out/stl/gozlem_govde.stl
cad/out/stl/gozlem_kubbe.stl
cad/out/stl/karsi_disli_m1_z30.stl
cad/out/stl/lok_baca.stl
cad/out/stl/lok_buhar_domu.stl
cad/out/stl/lok_emniyet_ventili.stl
cad/out/stl/lok_kabin.stl
cad/out/stl/lok_kabin_cati.stl
cad/out/stl/lok_kazan.stl
cad/out/stl/lok_kum_domu.stl
cad/out/stl/lok_platform_arka.stl
cad/out/stl/lok_platform_on.stl
cad/out/stl/pul_aks_4mm.stl
cad/out/stl/radar_anten.stl
cad/out/stl/radar_cati.stl
cad/out/stl/radar_direk.stl
cad/out/stl/radar_kabin.stl
cad/out/stl/radar_kaide.stl
cad/out/stl/radar_tabla.stl
cad/out/stl/ray_duz_200.stl
cad/out/stl/ray_viraj_r750_15.stl
cad/out/stl/sarj_cati.stl
cad/out/stl/sarj_govde.stl
cad/out/stl/sarj_istasyon.stl
cad/out/stl/sarj_kol.stl
cad/out/stl/sarj_platform.stl
cad/out/stl/sasi_motorlu_040.stl
cad/out/stl/sasi_test_040.stl
cad/out/stl/ses_cati.stl
cad/out/stl/ses_govde.stl
cad/out/stl/sonsuz_vida_m1.stl
cad/out/stl/tampon_250.stl
cad/out/stl/tekerlek_test_d42.stl
cad/out/stl/tender_depo.stl
cad/out/stl/tender_kapak.stl
cad/out/stl/tender_platform.stl
cad/out/stl/tender_sasi.stl
cad/out/stl/tolerans_kuponu.stl
cad/out/stl/vagon_boji.stl
cad/out/stl/vagon_cati.stl
cad/out/stl/vagon_govde.stl
cad/out/stl/vagon_platform.stl
cad/out/stl/vagon_platform_250.stl
cad/out/stl/yolcu_cati.stl
cad/out/stl/yolcu_govde.stl
