rytsh/tren/cad/renders/enerji250_montaj.png

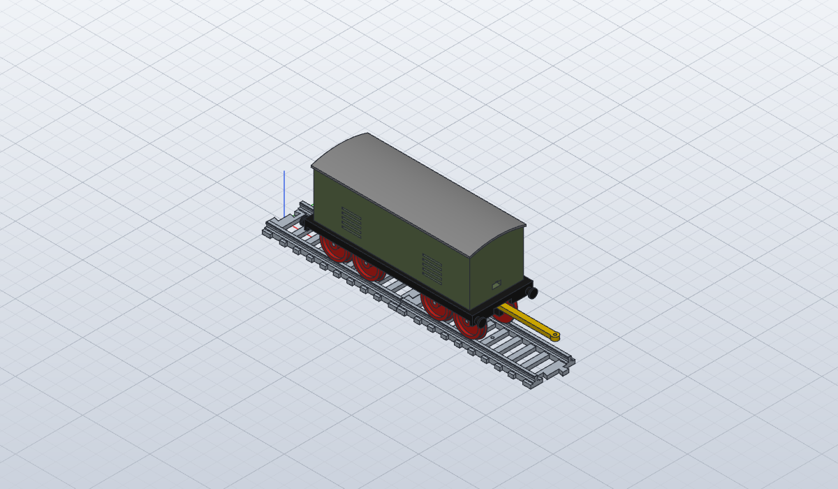
cad/renders/enerji250_montaj.png
