rytsh/tren/cad/renders/lokomotif_montaj.png

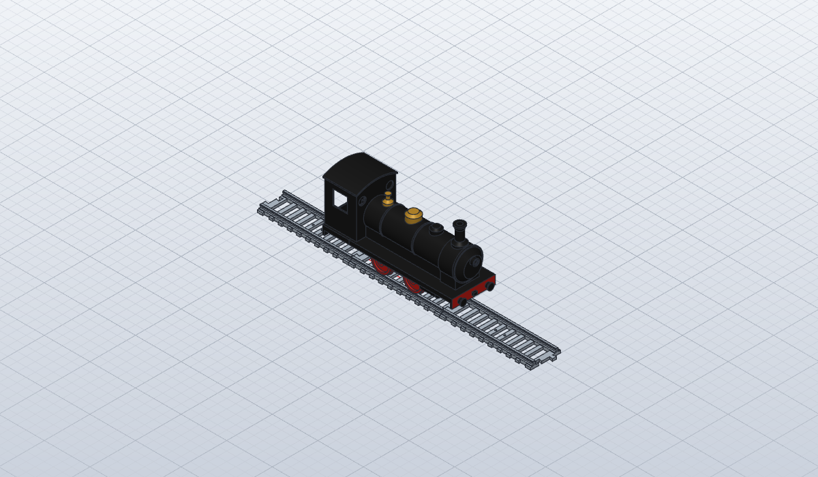
cad/renders/lokomotif_montaj.png
