rytsh/tren/cad/renders/montaj_iso.png

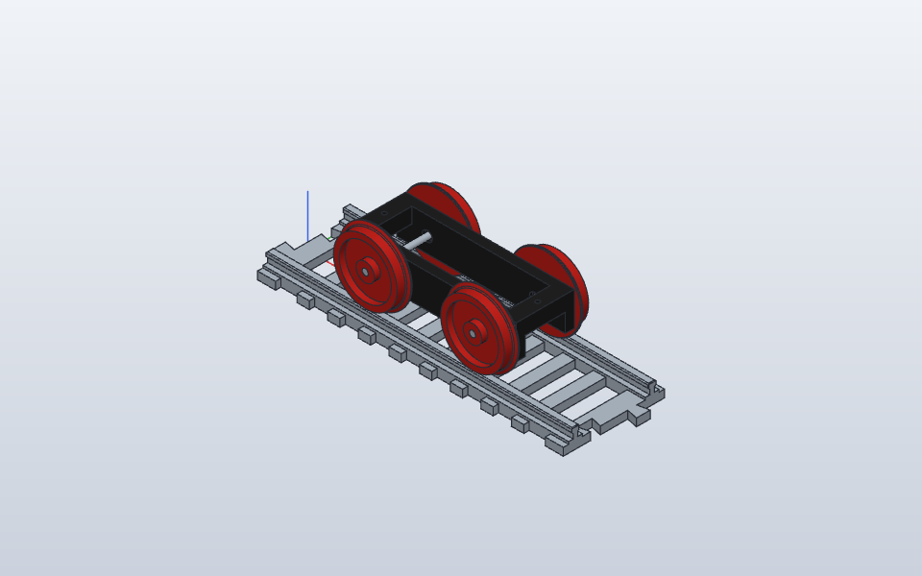
cad/renders/montaj_iso.png
