rytsh/tren/cad/renders/montaj_motorlu.png

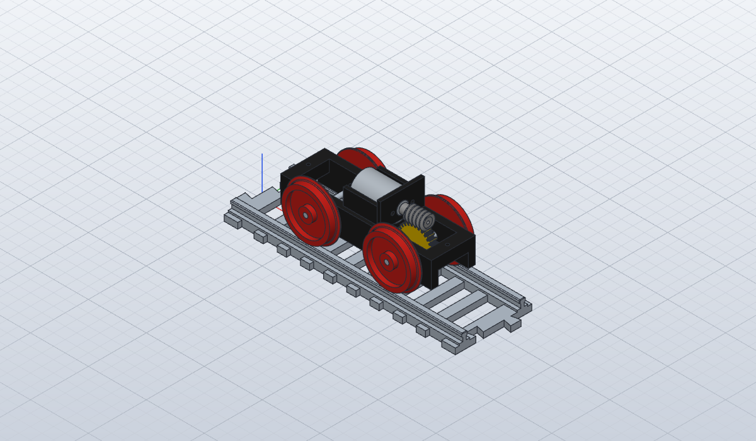
cad/renders/montaj_motorlu.png
