rytsh/tren/cad/renders/montaj_on.png

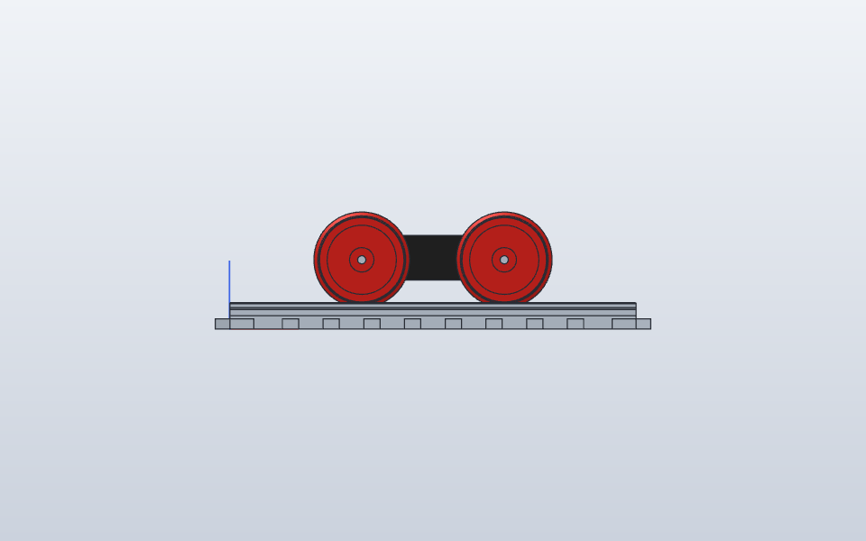
cad/renders/montaj_on.png
