rytsh/tren/cad/renders/radar250_montaj.png

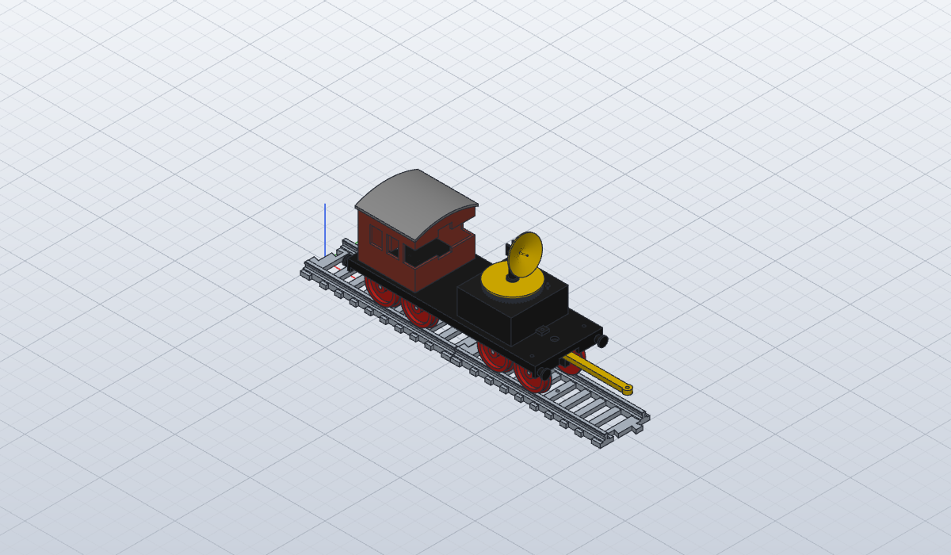
cad/renders/radar250_montaj.png
