rytsh/tren/cad/renders/sarj250_montaj.png

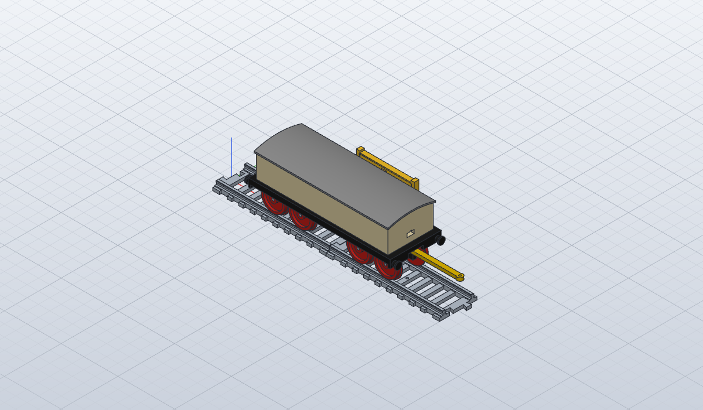
cad/renders/sarj250_montaj.png
