rytsh/tren/cad/renders/sasi250_montaj.png

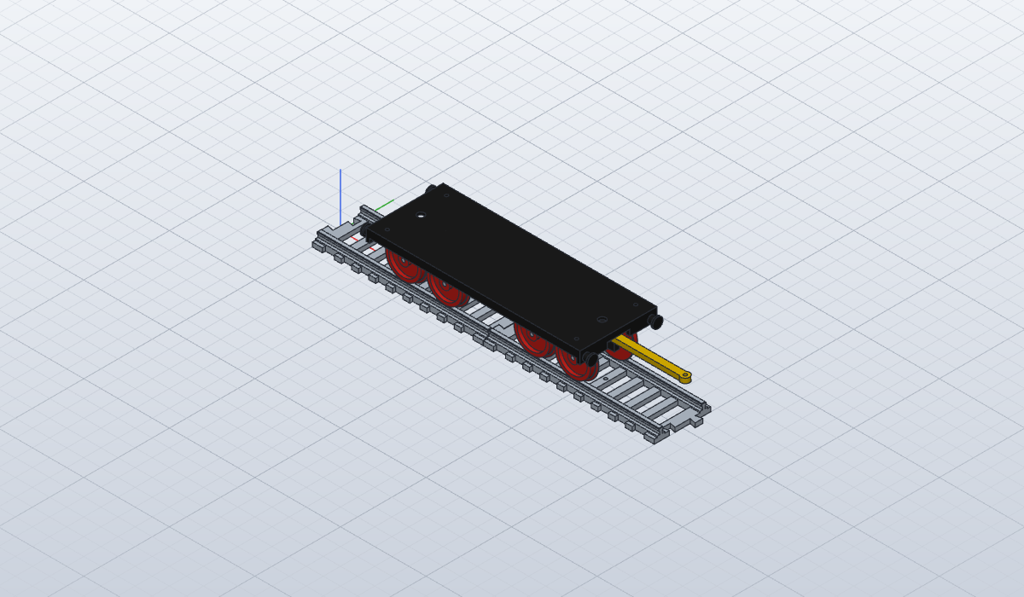
cad/renders/sasi250_montaj.png
