rytsh/tren/cad/renders/tender_montaj.png

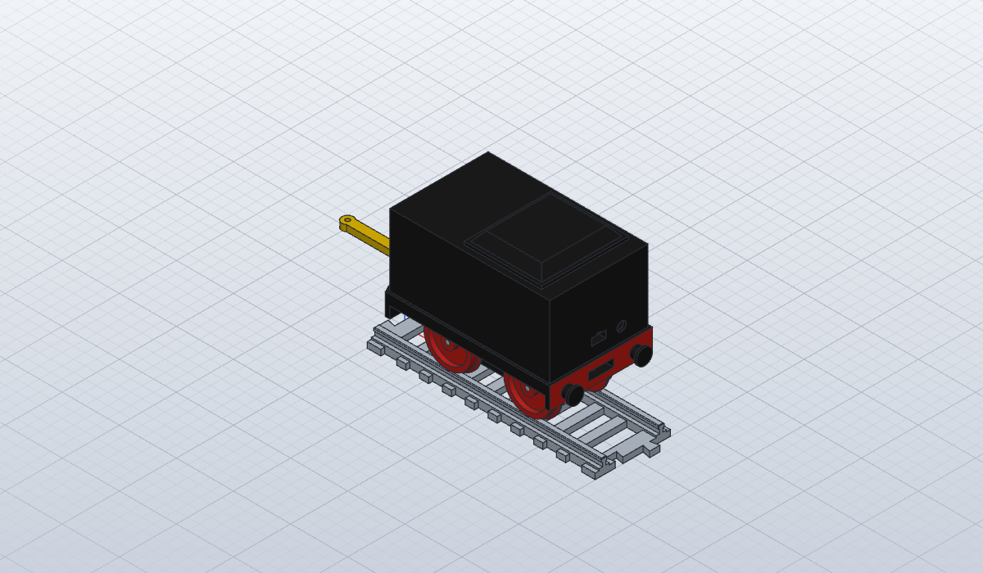
cad/renders/tender_montaj.png
