rytsh/tren/cad/renders/tekerlek_test_d42.png

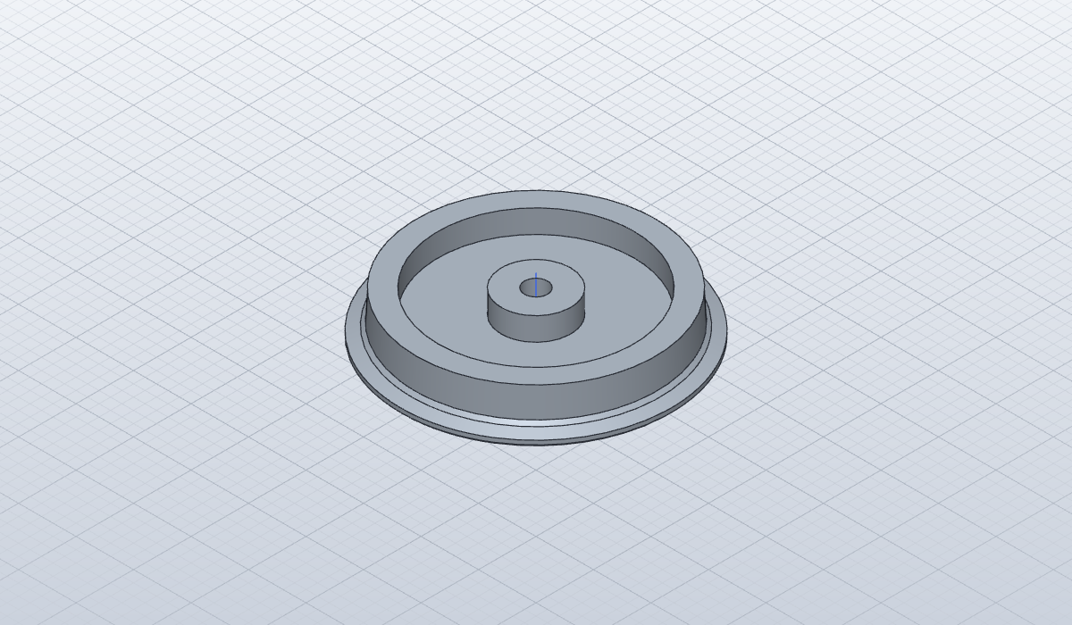
cad/renders/tekerlek_test_d42.png
