rytsh/tren/(commit log)

2026-11-04 Faz 1-2 CAD: ray, viraj, tekerlek, sasi, sonsuz vida aktarmasi (SolidCraft)
    [karsi_disli_m1_z30.3mf, karsi_disli_m1_z30.step, karsi_disli_m1_z30.stl, montaj_kontrol.step, montaj_motorlu.json, montaj_motorlu.measure.json, montaj_motorlu.step, pul_aks_4mm.3mf]
2026-11-04 Faz 3 CAD: lokomotif gövdesi (platform, kazan, kabin, baca, domlar), tender, yolcu vagonu ve bojisi; montaj kontrolleri, parts.json
    [ceki_kolu.3mf, ceki_kolu.step, ceki_kolu.stl, lok_baca.3mf, lok_baca.step, lok_baca.stl, lok_buhar_domu.3mf, lok_buhar_domu.step]
2026-11-04 Faz 3b CAD: tender/vagon araçlar arası 2-pin konnektör yuvası, iç kablo kelepçeleri, çatı LED yüzeyi (yalnız mekanik, ölçüler varsayım); R750 kablo/pim ön hesabı; inceleme amaçlı renkli montaj 3MF'le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
    [lokomotif_montaj.3mf, tender_depo.3mf, tender_depo.step, tender_depo.stl, tender_montaj.3mf, tender_montaj.step, vagon_cati.3mf, vagon_cati.step]
2026-11-05 Şarj 250: döner şarj kolları ve iki pirinç raylı istasyon
    Pabuç/pim arabası yerine yan cepten kapı gibi açılan üst (+) ve alt (-)
    kol; tek servo, ortak dikey mil, uçta 1,5 mm yaylı pirinç pabuç. Kapalıyken
    kollar cepte kalır, gövdeden taşmaz. İstasyonda iki direk arasında 90 mm
    üst üste iki pirinç ray.
    - Şekil 3 şarj istasyonu figürü Şarj 250 ve döner kollarla yeniden çizildi
    - Katalog Şarj 250 çizimi, catalog.ts ve Guide metinleri güncellendi
    - docs/standart.md: §5 İstasyon şarjı (tasarım önerisi, ölçüler varsayım)
2026-11-05 Faz 4 CAD: 250 vagon ortak şasisi, T45 kuplör ve Şarj 250 döner kolları; hat tasarlayıcı gerçek ölçülere bağlandı
    CAD (SolidCraft, build.py):
    - vagon_platform_250, tampon_250, kuplor_kafa, kuplor_kolu: ortak 250 şasi ve
    T45 kafa (koni/huni, 2 mıknatıs yuvası, 2 pogo cebi, kilit kulağı, kol yuvası)
    - Şarj 250: sarj_platform (servo pedleri), sarj_govde (yan kol cebi, ışık çubuğu),
    sarj_cati, sarj_kol (tek parça göbek + üst +/alt − kol, yaprak yay yuvası),
    sarj_istasyon (iki pirinç lamalı kontak tutucusu)
    - sarj250_montaj ve sasi250_montaj inceleme 3MF'leri; inspect.interference
    açık ve kapalı kol konumunda 0 çakışma
    - build.py PATH'teki solidcraf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
    [kuplor_kafa.3mf, kuplor_kafa.step, kuplor_kafa.stl, kuplor_kolu.3mf, kuplor_kolu.step, kuplor_kolu.stl, sarj250_montaj.3mf, sarj250_montaj.step]
2026-11-05 Faz 4b: T45 otomatik kuplör kaldırıldı; çeki kolu + 4 pinli TrenBus ara kablosu
    T45 (koni-huni, iki mıknatıs, iki pogo modülü, kilit kulağı) bu ölçekte fazla parça,
    ince duvar ve ±0,5 mm hizalama istiyordu. Mekanik bağlantı ile elektrik ayrıldı.
    CAD:
    - ceki_kolu_250 (116 mm) ve ceki_kolu_tender_250 (86 mm): tek parça, düz basılır
    - vagon_platform_250 / sarj_platform: iki uçta çeki kolu pivot göbeği (M3) ve
    kiriş altı ±12° kol çentiği
    - sarj_govde: iki alın duvarında 4 pinli TrenBus yuvası; alın kapısı yukarı alındı
    - kuplor_kafa / kuplor_kolu ve T45 parametreleri kaldırıldı
    - coupling_calc: 250 vagon çiftleri (R750 tampon payı ≈ 11 mm, kol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
    [ceki_kolu_250.3mf, ceki_kolu_250.step, ceki_kolu_250.stl, ceki_kolu_tender_250.3mf, ceki_kolu_tender_250.step, ceki_kolu_tender_250.stl, kuplor_kafa.3mf, kuplor_kafa.step]
2026-11-06 Tender deposu 4 pinli TrenBus yuvasına geçti; tender arkasında 86 mm çeki kolu
    - tender_depo: 2-pin aksesuar yuvaları yerine 250 vagonlarla aynı bus_socket,
    ana güç deliği yana (cable_y = 20) alındı
    - tender_montaj: arka çatalda ceki_kolu_tender_250; 0 çakışma
    - parts_manifest: tender için TrenBus konnektör ve ara kablo, 2-pin kalemler
    yalnız Faz 3 220 vagona
    [tender_depo.3mf, tender_depo.step, tender_depo.stl, tender_montaj.3mf, tender_montaj.step]
2026-11-06 Faz 4c: beş 250 vagonun gövdeleri (Yolcu, Enerji, Ses, Gözlem, Radar)
    CAD (15 yeni basılabilir parça, 5 inceleme montajı):
    - yolcu_govde/cati: 8 pencere, yan kapılar, şeffaf pencere bandı oluğu, LED yüzeyi
    - enerji_govde/cati: panjurlar, gösterge yarığı, iç pil rafı
    - ses_govde/cati: iki yanda Ø40 hoparlör ızgarası ve halkası, amfi kızağı
    - gozlem_govde/cati/kubbe: geniş pencereler, balkon ve korkuluk, kamera kubbesi
    - radar_kabin/cati/kaide/tabla/direk/anten: kısa kabin, N20 tahrikli m1 z56 tabla,
    direk çatalı ve çanak
    - Hepsi 4 pinli TrenBus yuvası, ortak platform vidaları; her montajda 0 çakışma
    Site:
    - Hat tasarlayıcısı ve 3D görüntüleyici ger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
    [enerji250_montaj.3mf, enerji250_montaj.step, enerji_cati.3mf, enerji_cati.step, enerji_cati.stl, enerji_govde.3mf, enerji_govde.step, enerji_govde.stl]
2026-11-06 Şekil 3 CAD ölçülerine hizalandı; belgelerde kalan T45 izleri
    - charging-station figürü: gövde 80 mm, kol/cep/lama ölçüleri params.json ile aynı,
    T45 kafası yerine çeki kolu, ön alın duvarında TrenBus yuvası
    - PRODUCT.md ve manifest notları güncellendi
